zolotarev88/kicad_lib/3dmod/User Library-PCI Express Mini Card (Full-Mini Card).step

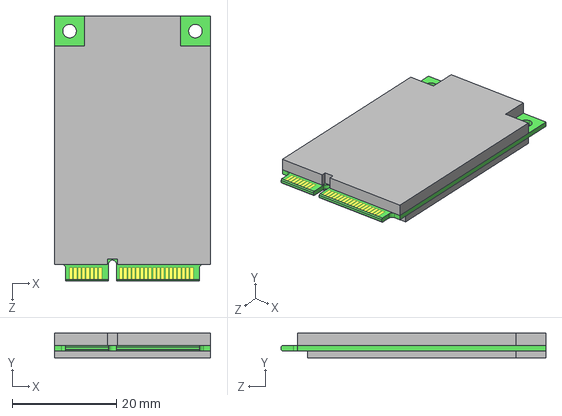
[picture p1: CAD file, 2020-07-09]
3dmod/User Library-PCI Express Mini Card (Full-Mini Card).step
30.0 x 4.75 x 51.0 mm
