zolotarev88/kicad_lib/3dmod/DG28C-B-08P-13-00A(H).stp

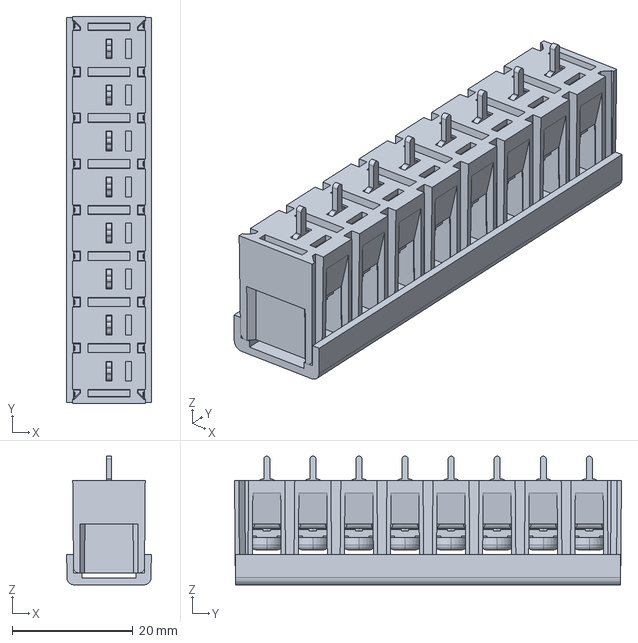
[picture p2: CAD file, 2025-03-10]
3dmod/DG28C-B-08P-13-00A(H).stp
14.0 x 64.0 x 21.3 mm
