zolotarev88/kicad_lib/3dmod/G5Q-14-EU DC5--3DModel-STEP-1.STEP

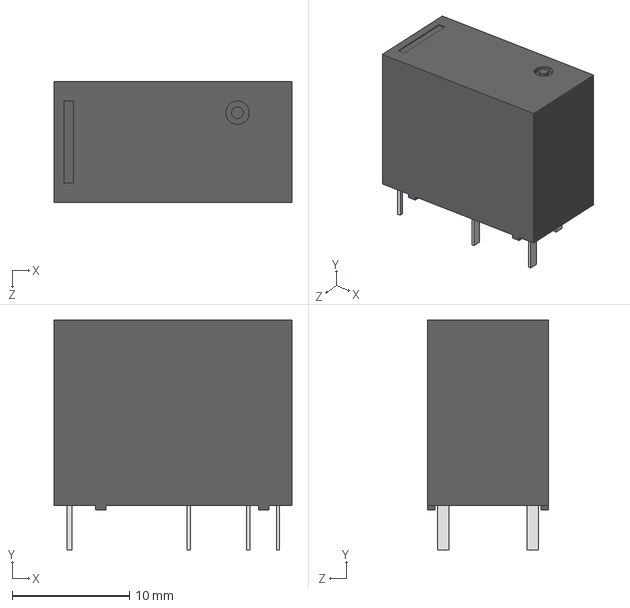
[picture p3: CAD file, 2025-03-10]
3dmod/G5Q-14-EU DC5--3DModel-STEP-1.STEP
20.3 x 19.6 x 10.3 mm
