zolotarev88/kicad_lib/3dmod/DG142V-5.08-08P-1Y-1000A(H).stp

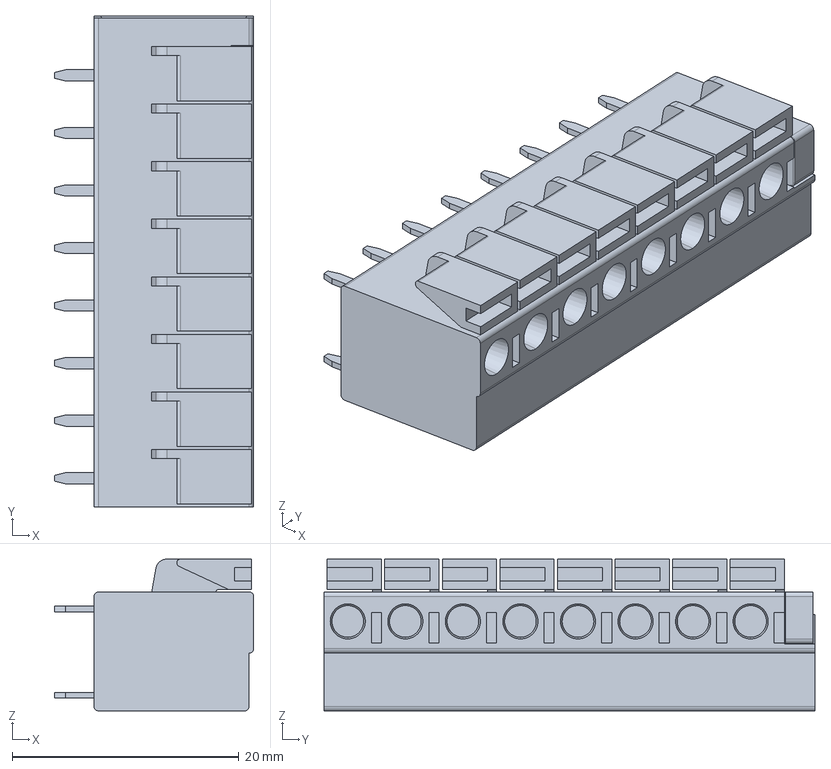
[picture p4: CAD file, 2025-03-10]
3dmod/DG142V-5.08-08P-1Y-1000A(H).stp
17.6 x 43.3 x 13.4 mm
