zolotarev88/kicad_lib/3dmod/FD6288Q.step

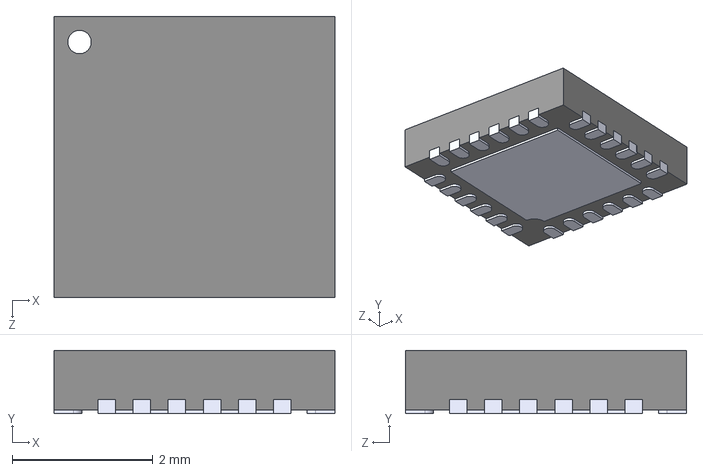
[picture p5: CAD file, 2025-03-10]
3dmod/FD6288Q.step
4.00 x 0.9 x 4.00 mm
