zolotarev88/kicad_lib/3dmod/LD05-23BxxR2.stp

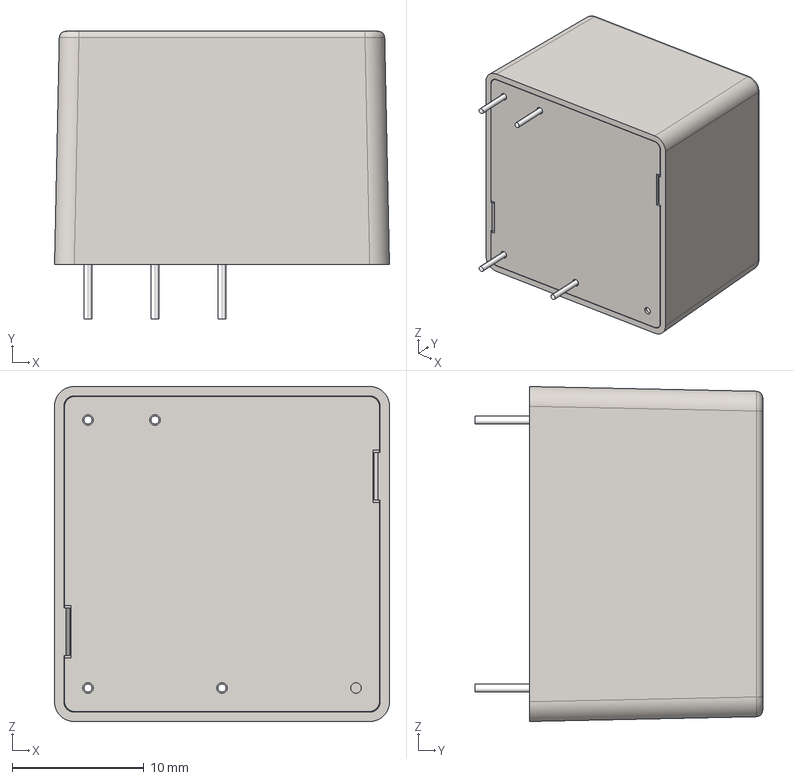
[picture p6: CAD file, 2025-03-10]
3dmod/LD05-23BxxR2.stp
25.4 x 21.8 x 25.4 mm
TOP_HOUSING_102_1
BOTTOM_HOUSING_62_1
16010014_AF2_13_1
16010014_AF5_13_1
16010014_AF3_13_1
16010014_AF4_13_1
