zolotarev88/kicad_lib/3dmod/WRA_S-3WR2.stp

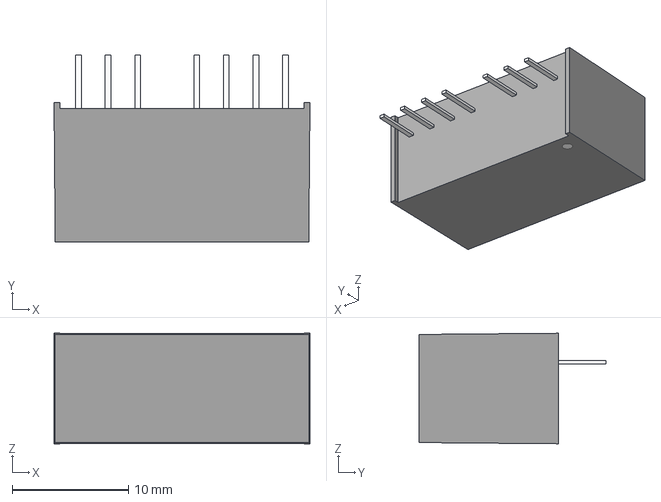
[picture p7: CAD file, 2023-01-25]
3dmod/WRA_S-3WR2.stp
22.0 x 16.1 x 9.50 mm
PIN_3_1_1_1 x 7
