zolotarev88/kicad_lib/3dmod/1-1393788-6.stp

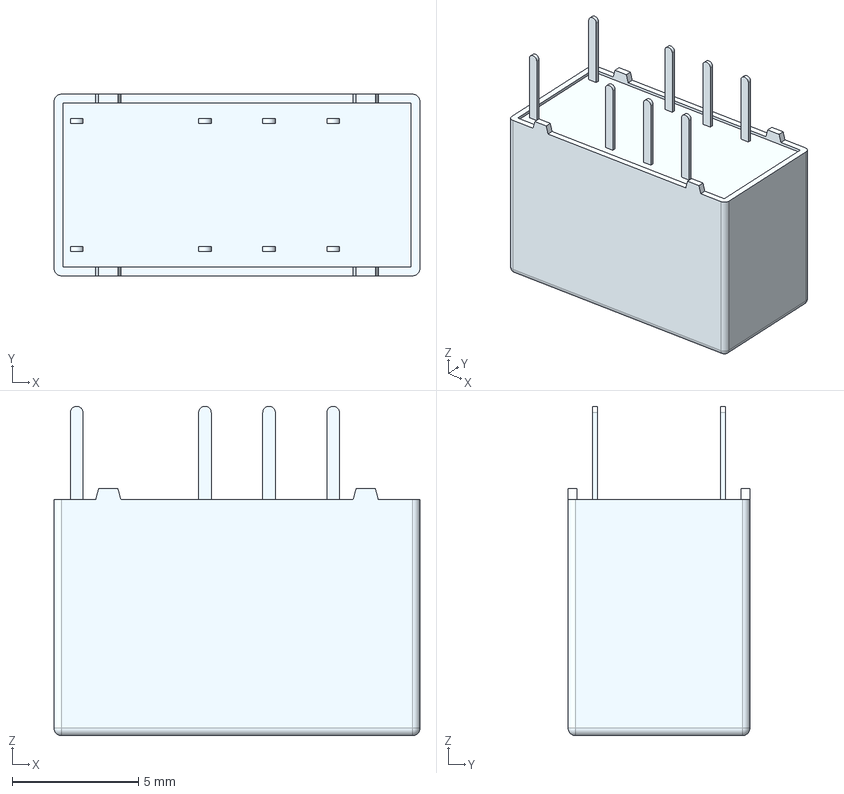
[picture p8: CAD file, 2023-01-25]
3dmod/1-1393788-6.stp
14.5 x 7.20 x 13.1 mm
