zolotarev88/kicad_lib/3dmod/ESP32-WROOM-32--3DModel-STEP-1.STEP

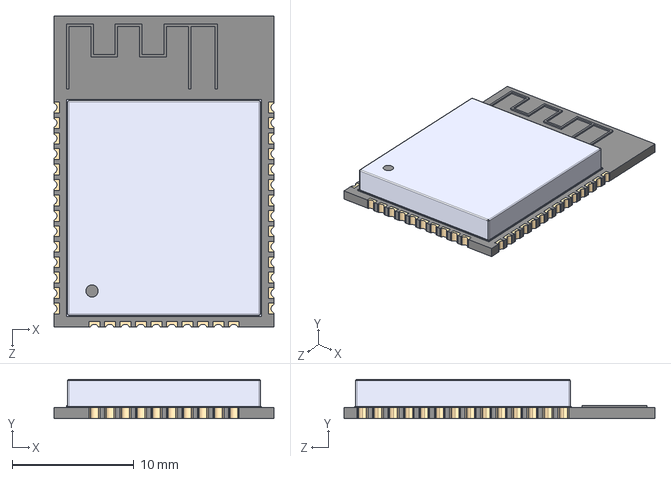
[picture p9: CAD file, 2023-01-25]
3dmod/ESP32-WROOM-32--3DModel-STEP-1.STEP
18.0 x 3.20 x 25.5 mm
