zolotarev88/kicad_lib/3dmod/User Library-CR2477.STEP

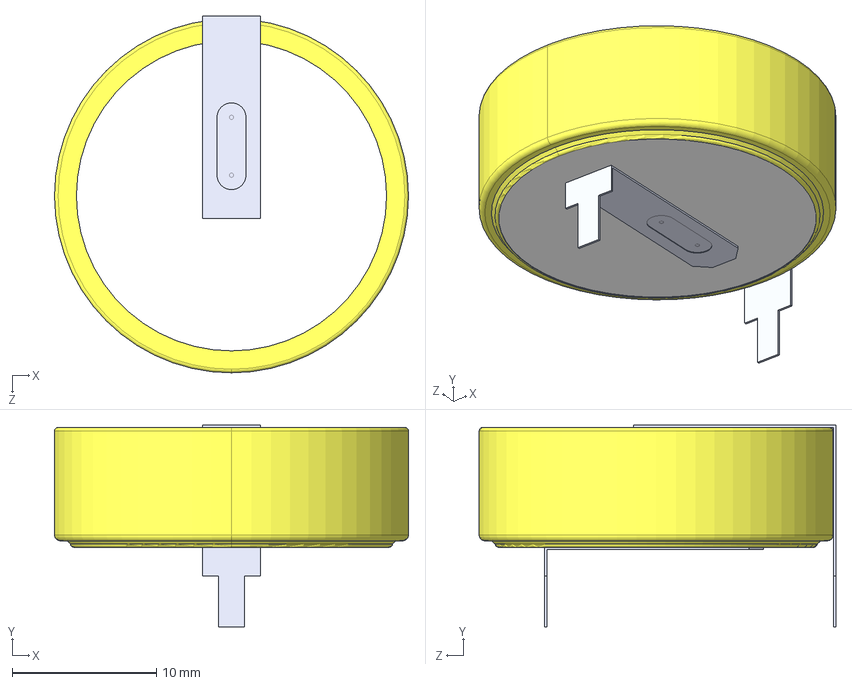
[picture p10: CAD file, 2023-01-25]
3dmod/User Library-CR2477.STEP
24.5 x 14.0 x 24.7 mm
CR2477_Body
CR2477_Anode
CR2477_Catode
