zolotarev88/kicad_lib/3dmod/User Library-096OLED.step

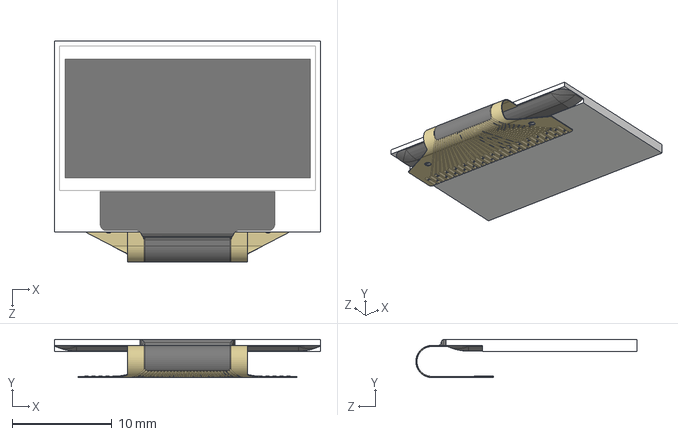
[picture p11: CAD file, 2023-01-25]
3dmod/User Library-096OLED.step
26.7 x 3.84 x 22.2 mm
