zolotarev88/kicad_lib/3dmod/RJ45-8L-B--3DModel-STEP-56544.STEP

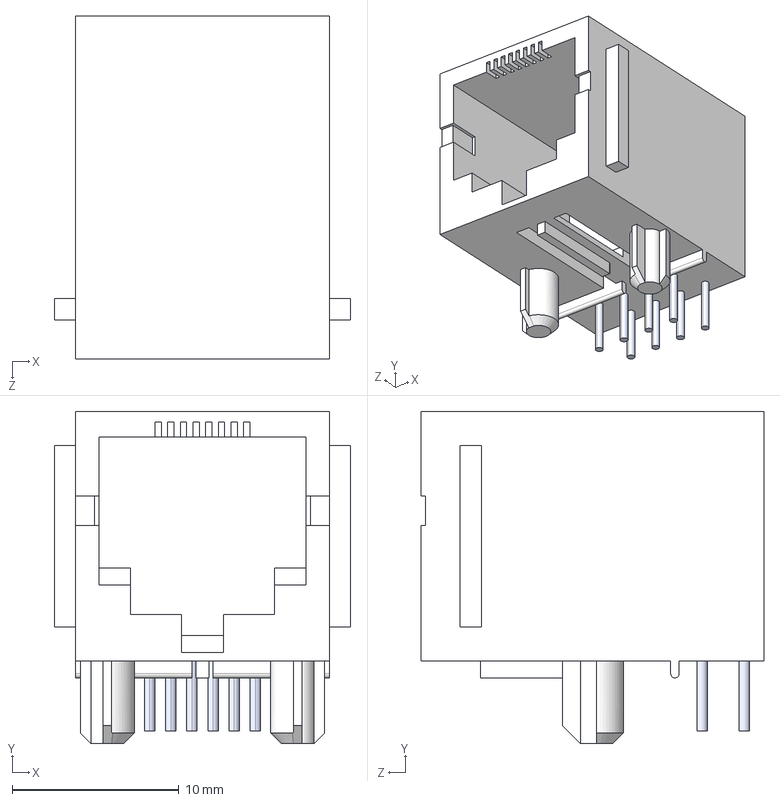
[picture p12: CAD file, 2023-01-25]
3dmod/RJ45-8L-B--3DModel-STEP-56544.STEP
17.8 x 19.9 x 20.6 mm
