zolotarev88/kicad_lib/3dmod/User Library-sd card.step

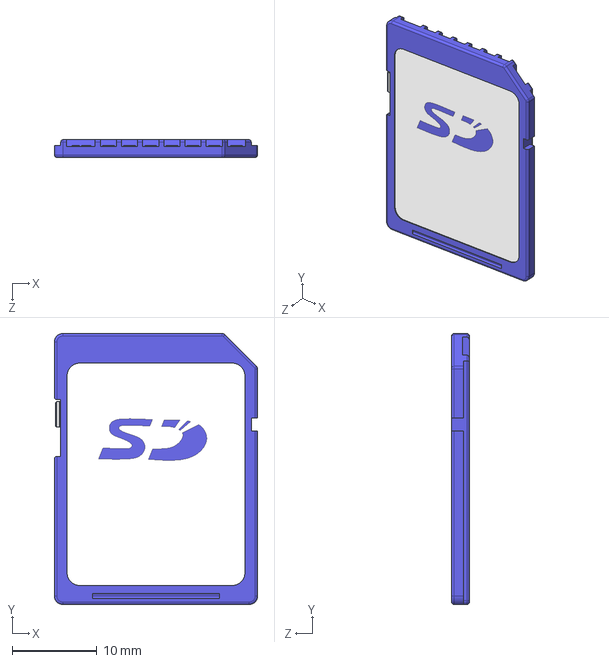
[picture p13: CAD file, 2022-01-13]
3dmod/User Library-sd card.step
24.0 x 32.0 x 2.10 mm
