zolotarev88/kicad_lib/3dmod/ACM2520-301-2P.stp

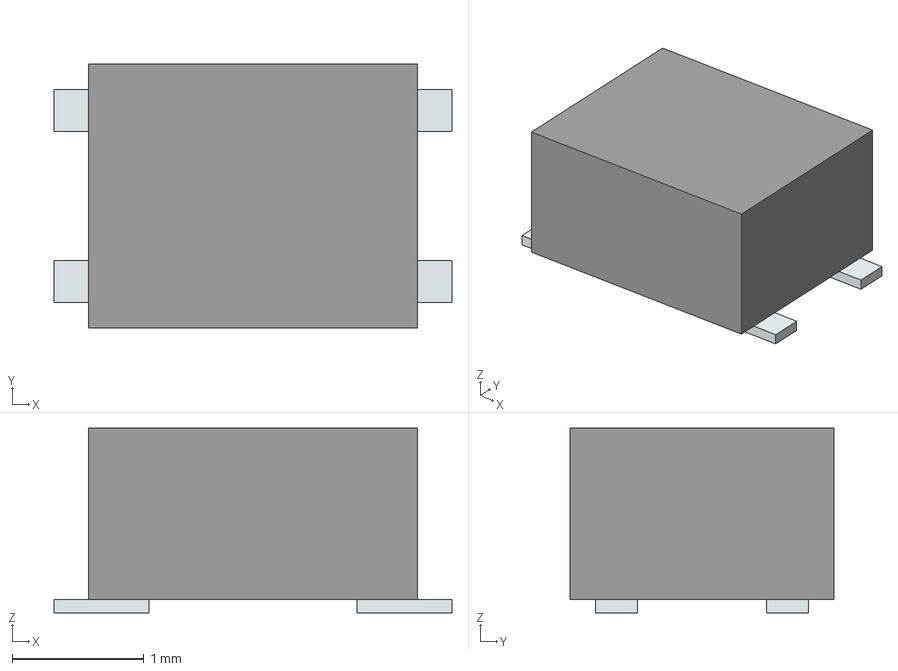
[picture p14: CAD file, 2022-01-13]
3dmod/ACM2520-301-2P.stp
3.02 x 2.00 x 1.40 mm
Pins
