zolotarev88/kicad_lib/3dmod/ACM2012-361-2P-T002.stp

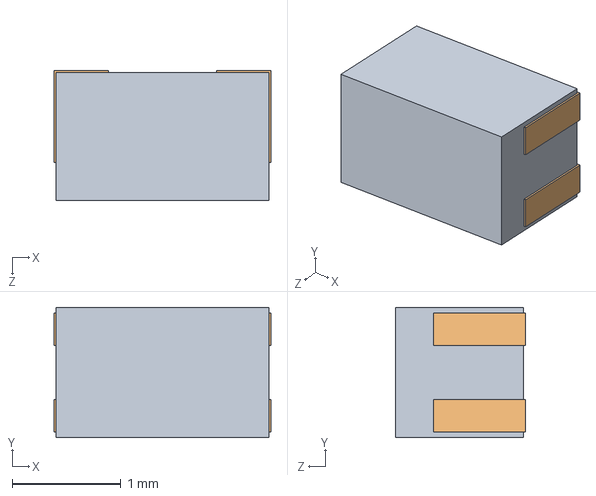
[picture p15: CAD file, 2022-01-13]
3dmod/ACM2012-361-2P-T002.stp
2.00 x 1.20 x 1.20 mm
ACM2012-T002 DRコアブロック(typ size)
ACM2012-T002 電極ブロック(typ size) x 4
