zolotarev88/kicad_lib/3dmod/LAN8720AI-CP.stp

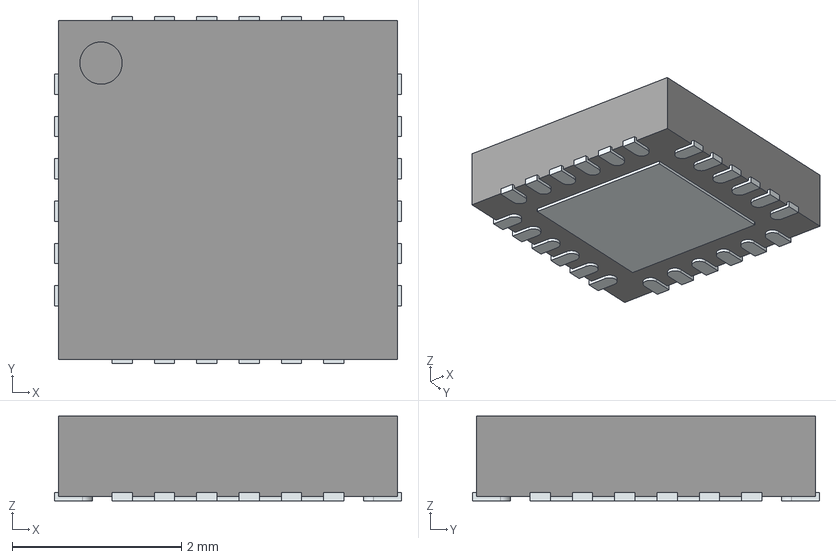
[picture p16: CAD file, 2022-01-13]
3dmod/LAN8720AI-CP.stp
4.10 x 4.10 x 1.00 mm
ThermalPin
PinsArrayLR
PinsArrayTB
