zolotarev88/kicad_lib/3dmod/mup-m015.step

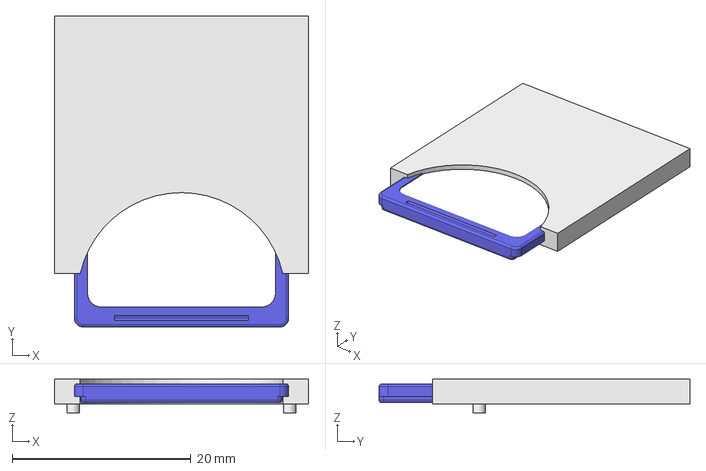
[picture p17: CAD file, 2022-01-13]
3dmod/mup-m015.step
28.4 x 34.8 x 3.80 mm
