zolotarev88/kicad_lib/3dmod/ESP32-D0WDQ6-V3.stp

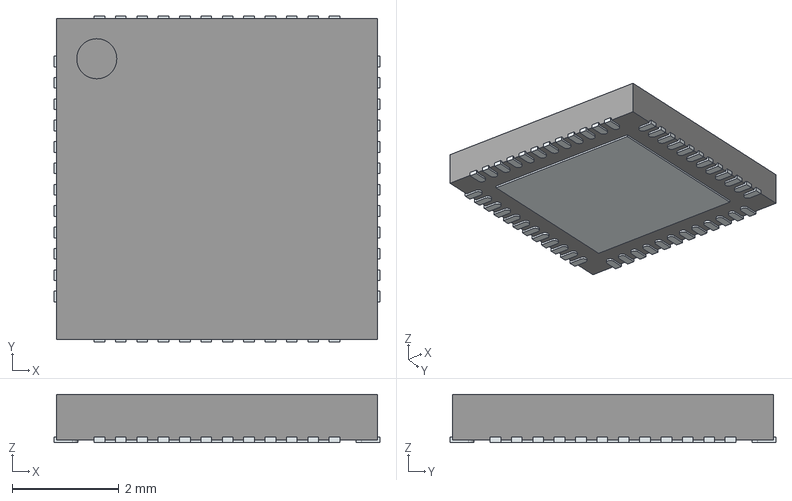
[picture p18: CAD file, 2022-01-13]
3dmod/ESP32-D0WDQ6-V3.stp
6.10 x 6.10 x 0.9 mm
ThermalPin
PinsArrayLR
PinsArrayTB
