zolotarev88/kicad_lib/3dmod/ESP32-WROOM-32D.stp

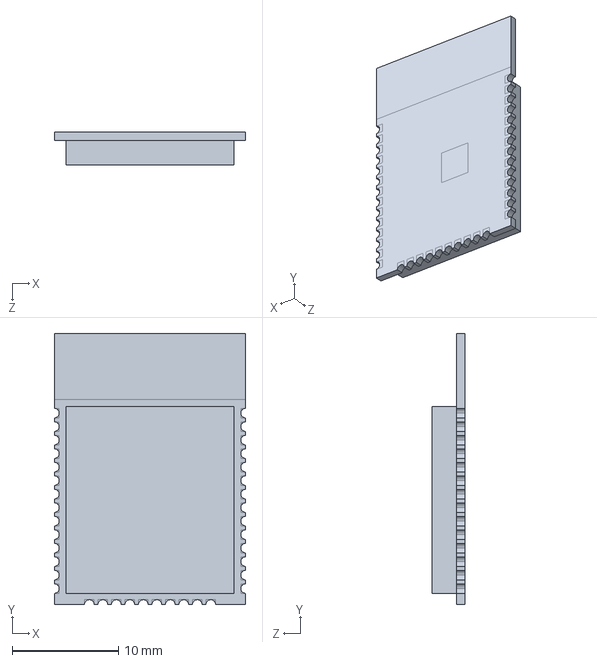
[picture p19: CAD file, 2022-01-13]
3dmod/ESP32-WROOM-32D.stp
18.0 x 25.5 x 3.10 mm
