zolotarev88/kicad_lib/3dmod/B2B-PH-SM4-TB(LF)(SN)--3DModel-STEP-56544.STEP

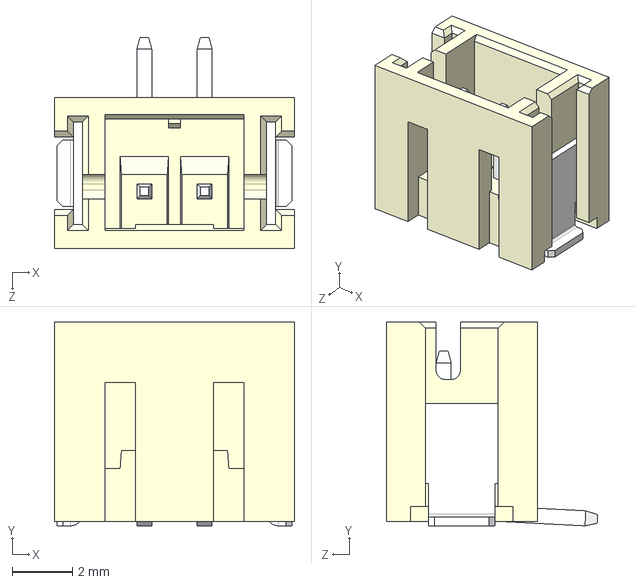
[picture p20: CAD file, 2022-01-13]
3dmod/B2B-PH-SM4-TB(LF)(SN)--3DModel-STEP-56544.STEP
7.95 x 6.75 x 7.00 mm
