zolotarev88/kicad_lib/3dmod/CR2032_MFR_FH2.stp

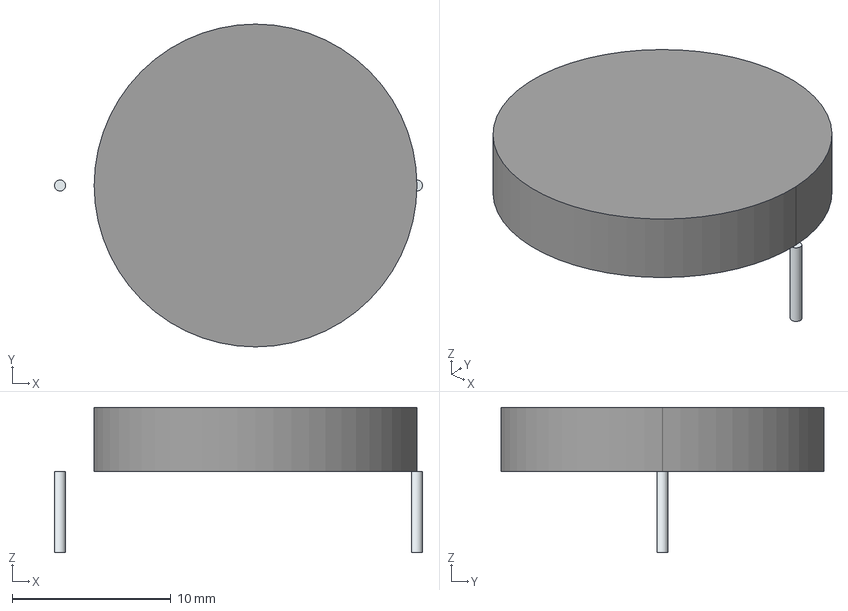
[picture p21: CAD file, 2021-04-29]
3dmod/CR2032_MFR_FH2.stp
23.2 x 20.4 x 9.15 mm
Leads x 2
