zolotarev88/kicad_lib/3dmod/TD_H_541S485H.stp

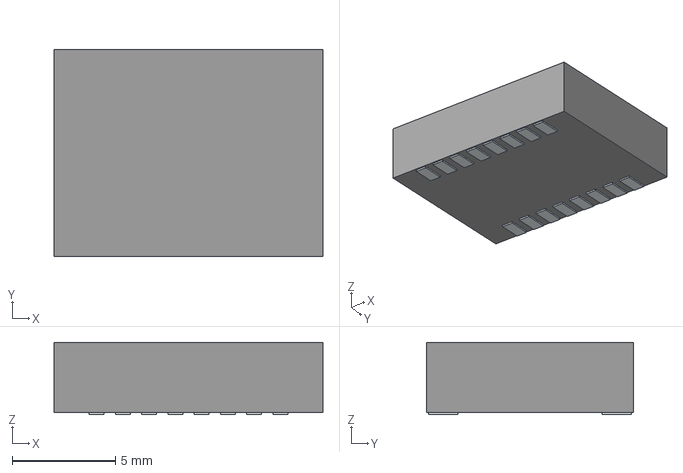
[picture p22: CAD file, 2021-04-29]
3dmod/TD_H_541S485H.stp
13.0 x 10.0 x 3.50 mm
Pins
