zolotarev88/kicad_lib/3dmod/SI3402-B-GMR.stp

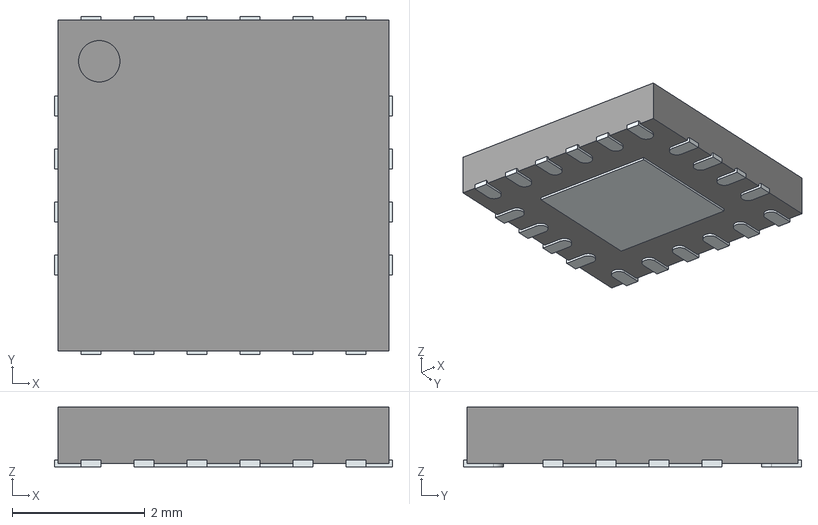
[picture p23: CAD file, 2021-04-29]
3dmod/SI3402-B-GMR.stp
5.10 x 5.10 x 0.9 mm
ThermalPin
PinsArrayLR
PinsArrayTB
