zolotarev88/kicad_lib/3dmod/QFN24_3X3X1_IVS.step

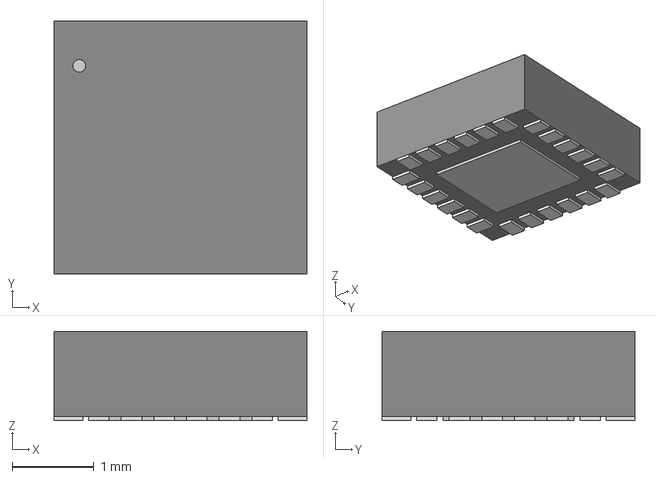
[picture p24: CAD file, 2021-04-29]
3dmod/QFN24_3X3X1_IVS.step
3.10 x 3.10 x 1.09 mm
