zolotarev88/kicad_lib/3dmod/BS-7.STEP

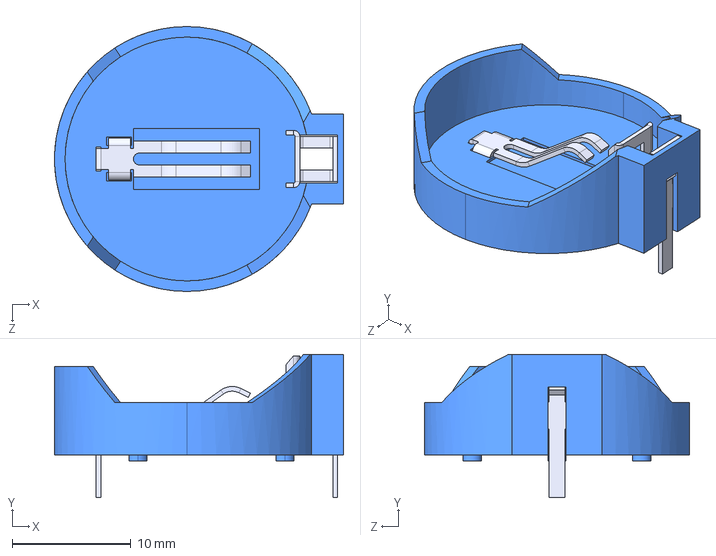
[picture p25: CAD file, 2021-04-29]
3dmod/BS-7.STEP
24.4 x 12.1 x 22.4 mm
