zolotarev88/kicad_lib/3dmod/WM8962BECSN_R.stp

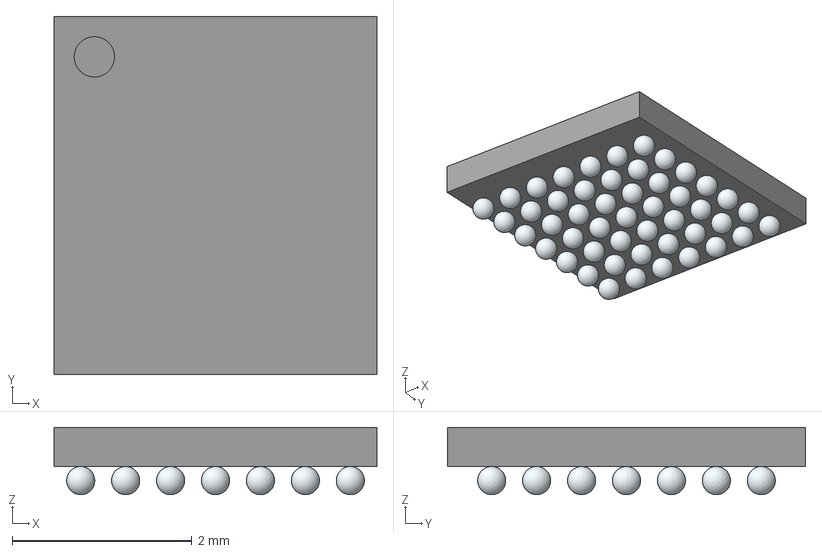
[picture p26: CAD file, 2021-03-23]
3dmod/WM8962BECSN_R.stp
3.59 x 3.98 x 0.75 mm
