zolotarev88/kicad_lib/3dmod/WM8904CGEFL_V.stp

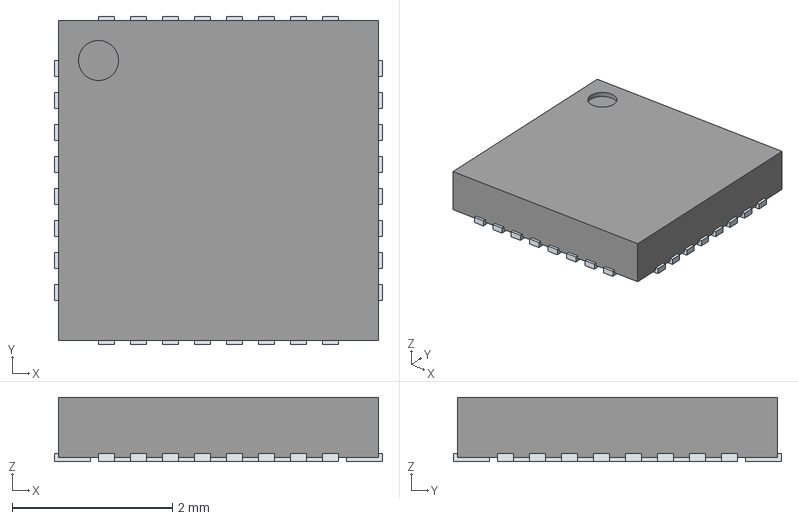
[picture p27: CAD file, 2021-03-23]
3dmod/WM8904CGEFL_V.stp
4.10 x 4.10 x 0.8 mm
ThermalPin
PinsArrayLR
PinsArrayTB
