zolotarev88/kicad_lib/3dmod/WM8960CGEFL_V.stp

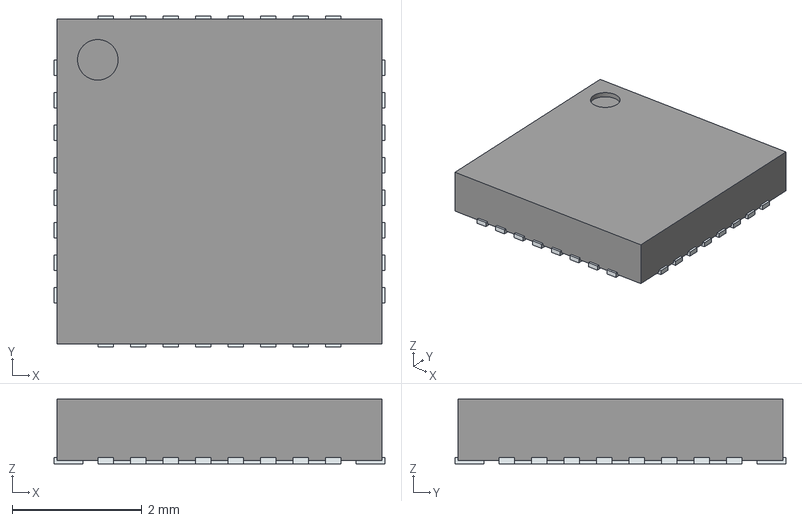
[picture p28: CAD file, 2021-03-23]
3dmod/WM8960CGEFL_V.stp
5.10 x 5.10 x 1.00 mm
ThermalPin
PinsArrayLR
PinsArrayTB
