zolotarev88/kicad_lib/3dmod/TDA7491HV13TR.stp

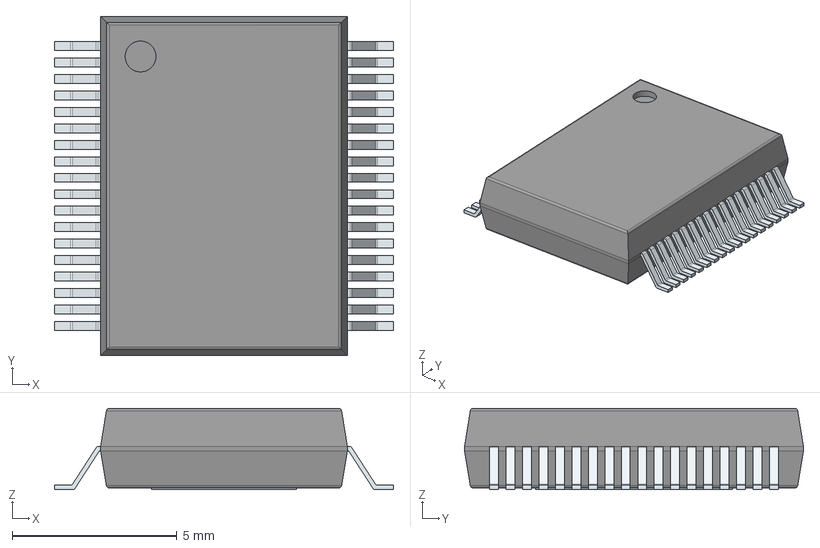
[picture p29: CAD file, 2021-01-18]
3dmod/TDA7491HV13TR.stp
10.3 x 10.3 x 2.47 mm
PinsArrayLR
ThermalPad
