zolotarev88/kicad_lib/3dmod/TPA3138D2PWPR.stp

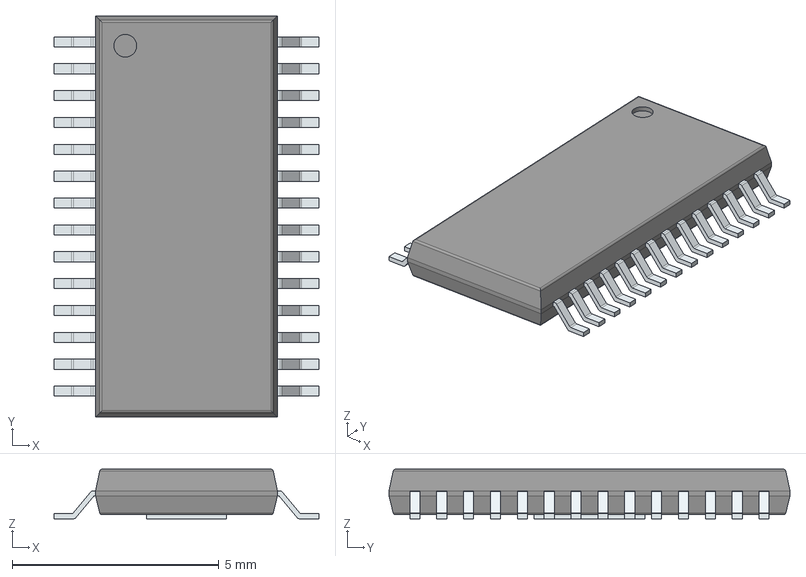
[picture p30: CAD file, 2021-01-18]
3dmod/TPA3138D2PWPR.stp
6.40 x 9.70 x 1.20 mm
PinsArrayLR
ThermalPad
