zolotarev88/kicad_lib/3dmod/B3B-PH-SM4-TB.STEP

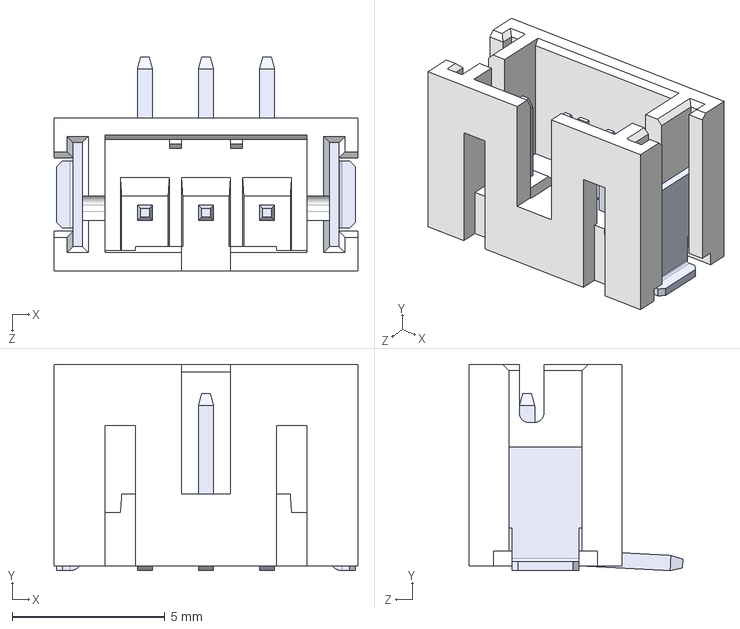
[picture p31: CAD file, 2020-12-24]
3dmod/B3B-PH-SM4-TB.STEP
9.95 x 6.75 x 7.00 mm
