zolotarev88/kicad_lib/3dmod/IS62WV102416FBLL-45BLI.stp

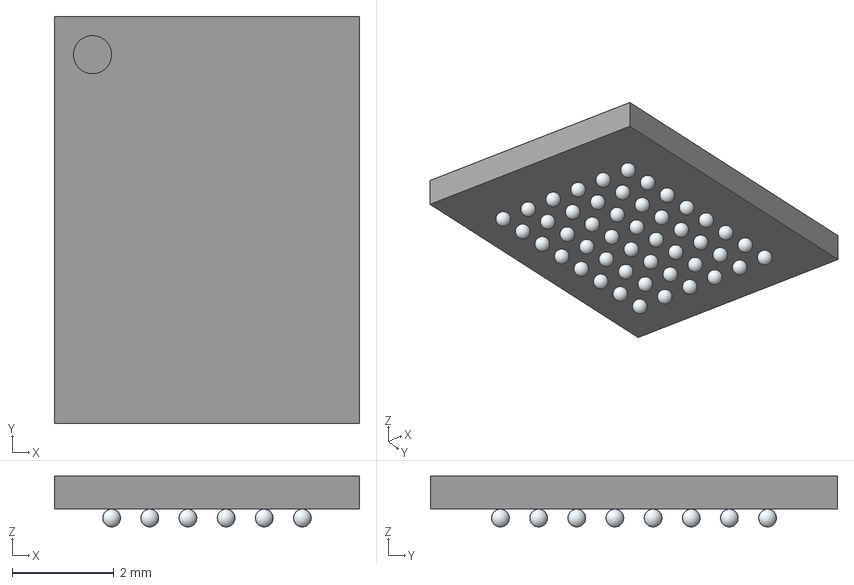
[picture p32: CAD file, 2020-12-24]
3dmod/IS62WV102416FBLL-45BLI.stp
6.00 x 8.00 x 1.00 mm
