zolotarev88/kicad_lib/3dmod/TP4056.stp

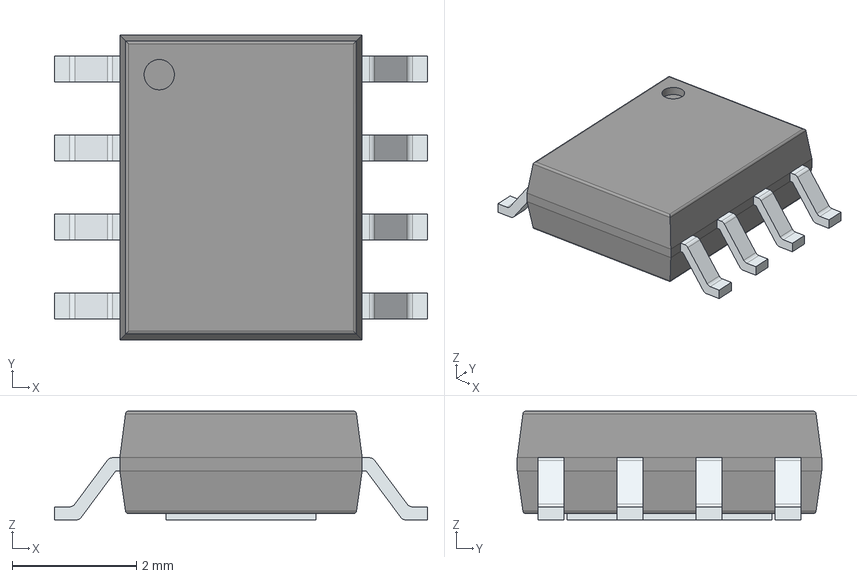
[picture p33: CAD file, 2020-12-24]
3dmod/TP4056.stp
6.00 x 4.90 x 1.75 mm
PinsArrayLR
ThermalPad
