zolotarev88/kicad_lib/3dmod/S4B-PH-K-S.STEP

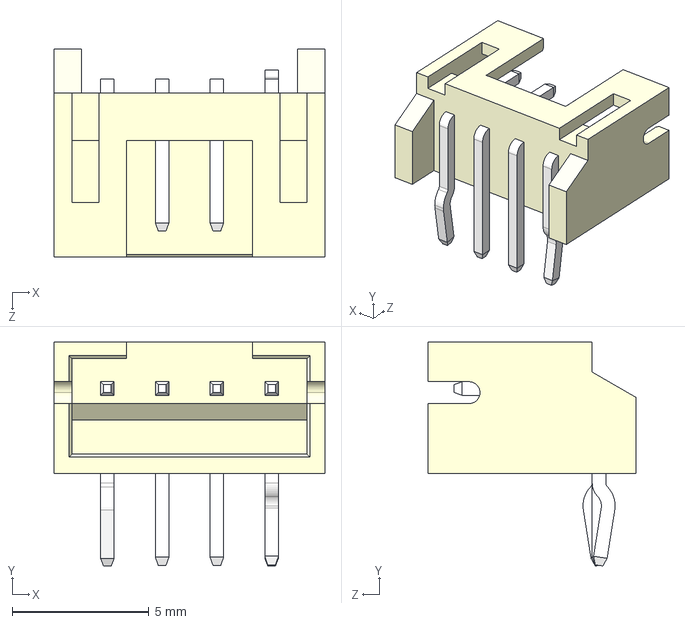
[picture p34: CAD file, 2020-12-24]
3dmod/S4B-PH-K-S.STEP
9.90 x 8.18 x 7.60 mm
