zolotarev88/kicad_lib/3dmod/c-2041021-1-b-3d.stp

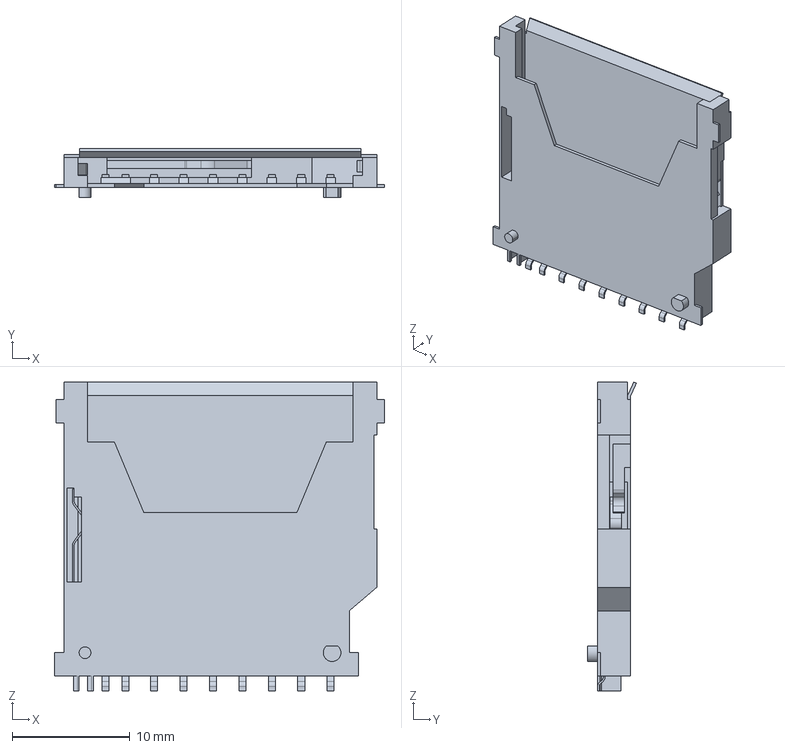
[picture p35: CAD file, 2020-12-24]
3dmod/c-2041021-1-b-3d.stp
28.0 x 4.15 x 26.2 mm
