zolotarev88/kicad_lib/3dmod/RCLAMP0524PATCT.stp

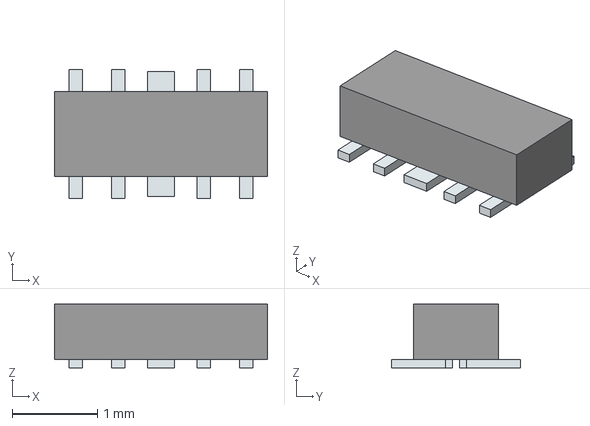
[picture p36: CAD file, 2020-12-24]
3dmod/RCLAMP0524PATCT.stp
2.50 x 1.51 x 0.75 mm
Pins
