zolotarev88/kicad_lib/3dmod/SM03B-SRSS-TB(LF)(SN)--3DModel-STEP-56544.STEP

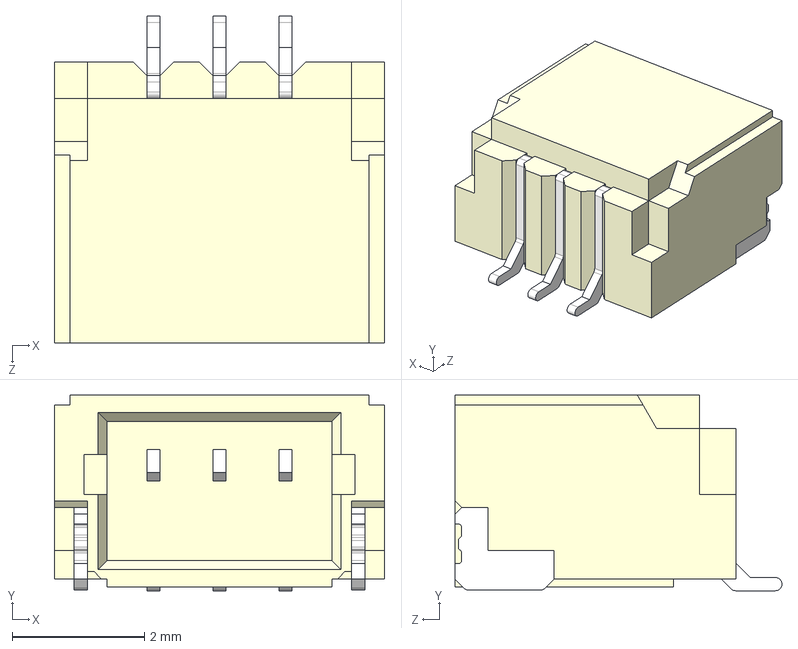
[picture p37: CAD file, 2020-12-24]
3dmod/SM03B-SRSS-TB(LF)(SN)--3DModel-STEP-56544.STEP
5.00 x 2.96 x 4.95 mm
