zolotarev88/kicad_lib/3dmod/GL823K.stp

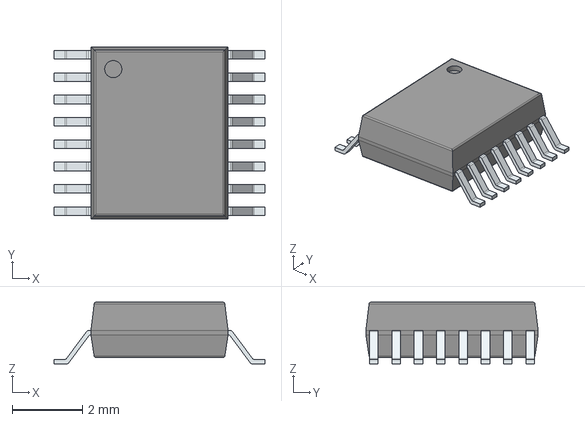
[picture p38: CAD file, 2020-12-24]
3dmod/GL823K.stp
6.00 x 4.90 x 1.75 mm
PinsArrayLR
