zolotarev88/kicad_lib/3dmod/TS-1187A-B-A-B--3DModel-STEP-56544.STEP

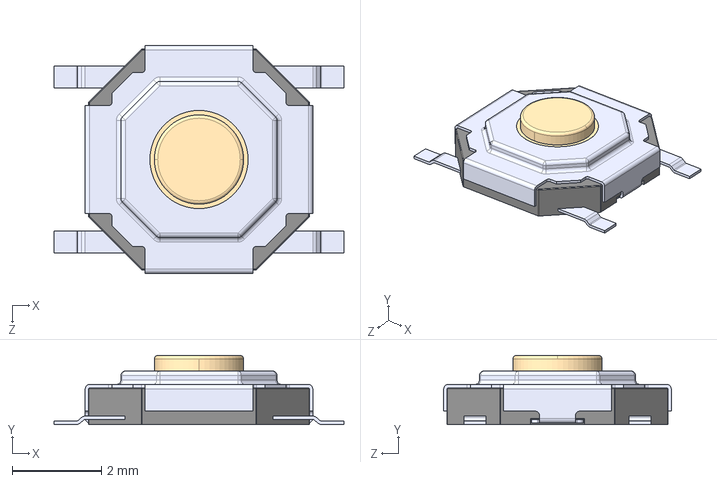
[picture p39: CAD file, 2020-09-29]
3dmod/TS-1187A-B-A-B--3DModel-STEP-56544.STEP
6.50 x 1.55 x 5.10 mm
