zolotarev88/kicad_lib/3dmod/SWPA3015S2R2NT.stp

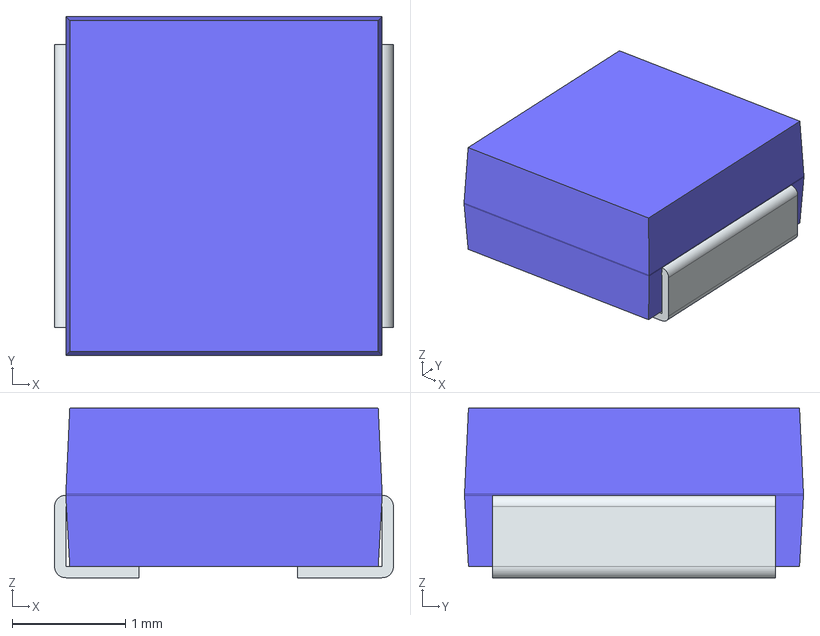
[picture p41: CAD file, 2020-09-14]
3dmod/SWPA3015S2R2NT.stp
3.00 x 3.00 x 1.50 mm
FilletPin1
FilletPin2
