zolotarev88/kicad_lib/3dmod/User Library-FFC 6x05.step

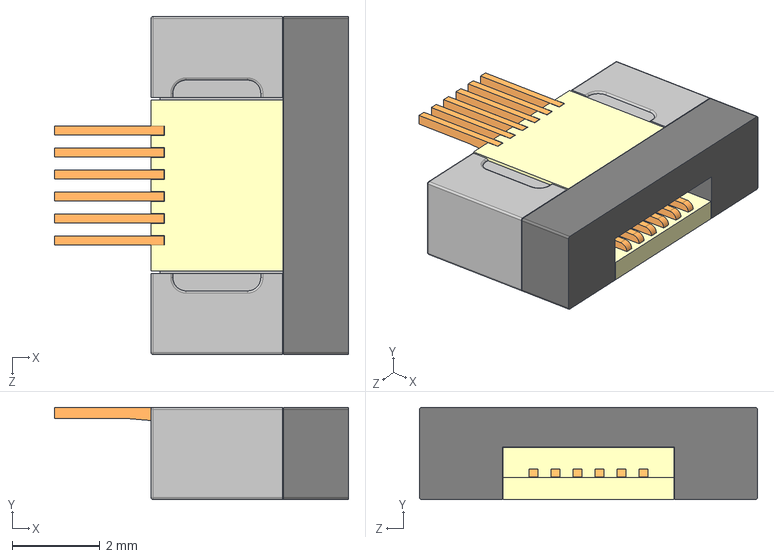
[picture p42: CAD file, 2020-09-14]
3dmod/User Library-FFC 6x05.step
6.70 x 2.10 x 7.70 mm
