zolotarev88/kicad_lib/3dmod/3-1734839-0--3DModel-STEP-56544.STEP

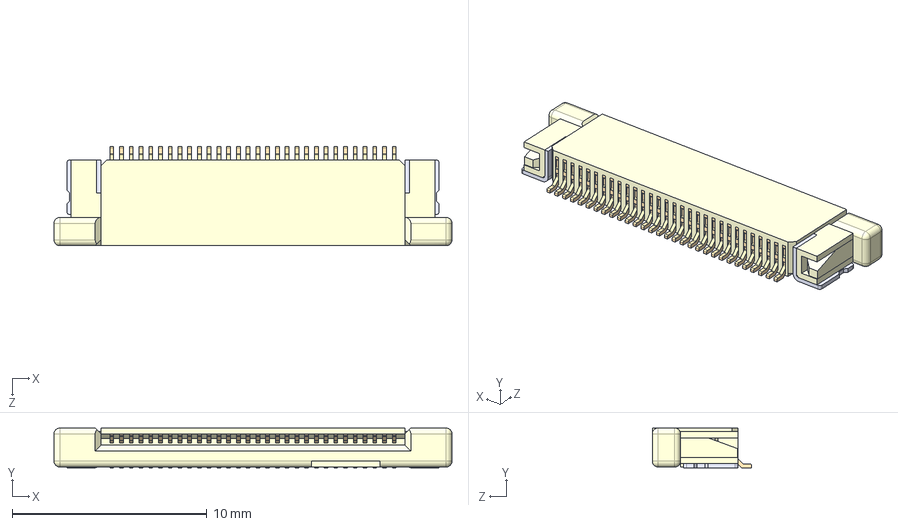
[picture p43: CAD file, 2020-09-14]
3dmod/3-1734839-0--3DModel-STEP-56544.STEP
20.4 x 2.05 x 5.10 mm
