zolotarev88/kicad_lib/3dmod/SWPA4012S2R2NT--3DModel-STEP-56544.STEP

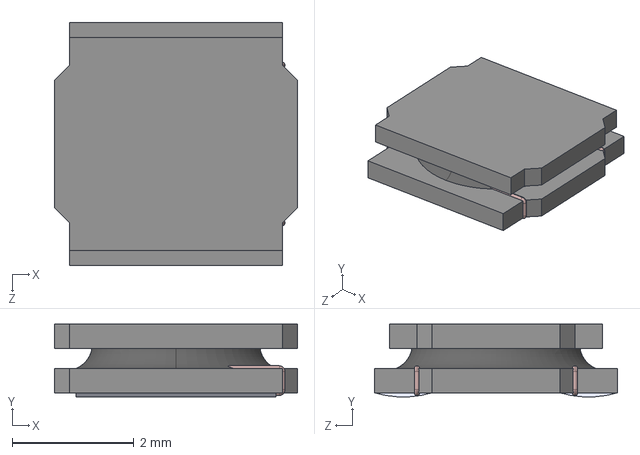
[picture p44: CAD file, 2020-09-14]
3dmod/SWPA4012S2R2NT--3DModel-STEP-56544.STEP
4.00 x 1.20 x 4.00 mm
