zolotarev88/kicad_lib/3dmod/SM04B-SRSS-TB(LF)(SN)--3DModel-STEP-56544.STEP

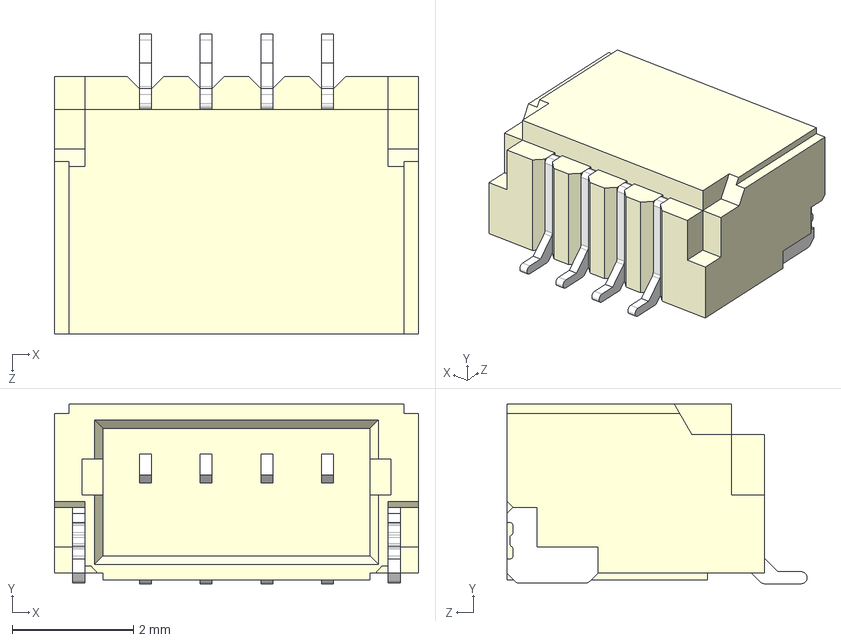
[picture p45: CAD file, 2020-09-14]
3dmod/SM04B-SRSS-TB(LF)(SN)--3DModel-STEP-56544.STEP
6.00 x 2.96 x 4.95 mm
