zolotarev88/kicad_lib/3dmod/User Library-mc-306 crystal.step

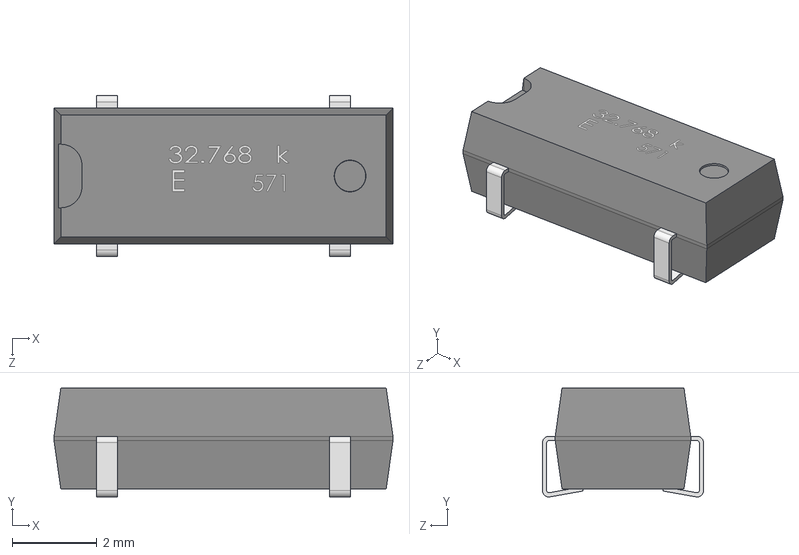
[picture p46: CAD file, 2020-09-14]
3dmod/User Library-mc-306 crystal.step
8.00 x 2.57 x 3.80 mm
