zolotarev88/kicad_lib/3dmod/6027.step

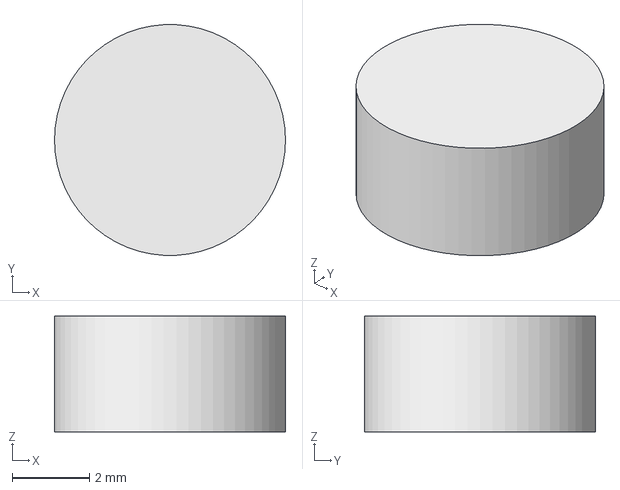
[picture p47: CAD file, 2020-09-14]
3dmod/6027.step
6.00 x 5.99 x 3.00 mm
