zolotarev88/kicad_lib/3dmod/3-1734592-5.stp

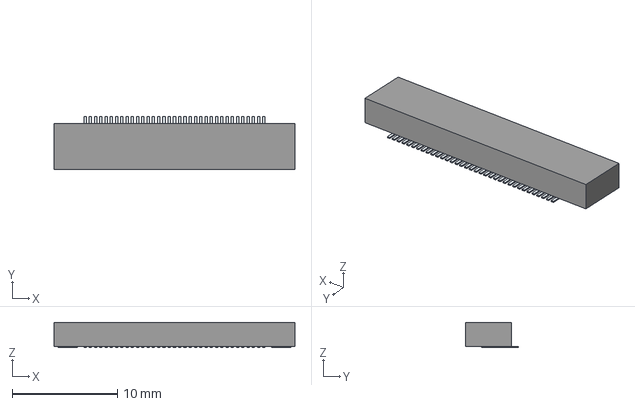
[picture p48: CAD file, 2020-09-14]
3dmod/3-1734592-5.stp
22.9 x 5.07 x 2.40 mm
Pins
