zolotarev88/kicad_lib/3dmod/NT6AN256T32AV-J2.stp

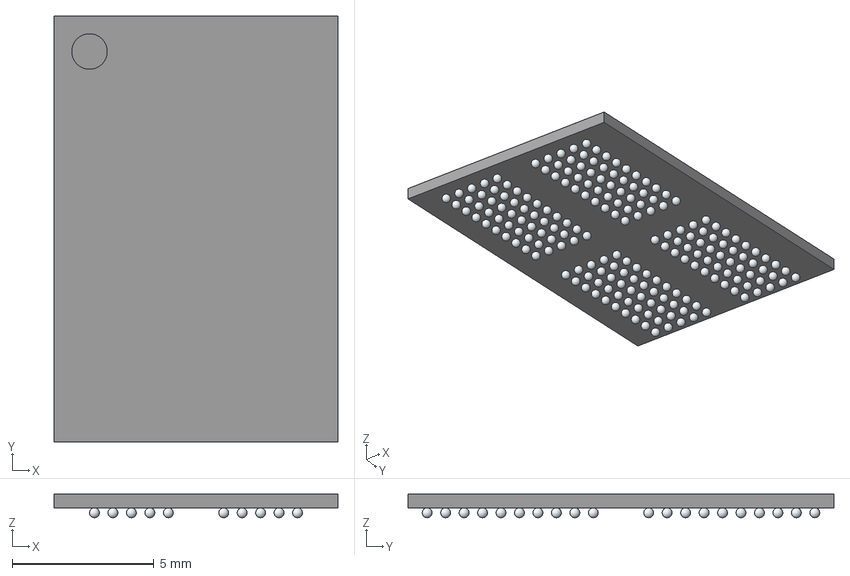
[picture p49: CAD file, 2020-08-24]
3dmod/NT6AN256T32AV-J2.stp
10.0 x 15.0 x 0.83 mm
A1
A2
A3
A4
A5
A8
A9
A10
A11
A12
B1
B2
B3
B4
B5
B8
B9
B10
B11
B12
C1
C2
C3
C4
C5
C8
C9
C10
C11
C12
D1
D2
D3
D4
D5
D8
D9
D10
D11
D12
E1
E2
E3
E4
E5
E8
E9
E10
E11
E12
F1
F2
F3
F4
F5
F8
F9
F10
F11
F12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
