zolotarev88/kicad_lib/3dmod/L-7104FO-2GD_.stp

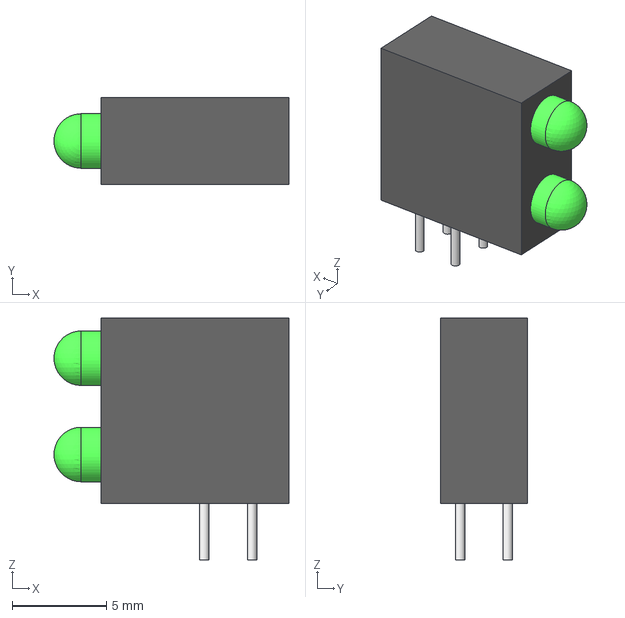
[picture p50: CAD file, 2020-08-24]
3dmod/L-7104FO-2GD_.stp
12.5 x 4.60 x 12.8 mm
