zolotarev88/kicad_lib/3dmod/ADM2682EBRIZ.stp

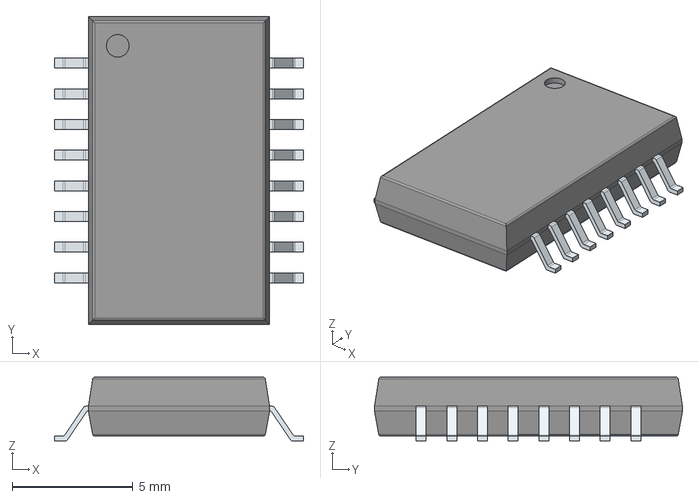
[picture p51: CAD file, 2020-08-24]
3dmod/ADM2682EBRIZ.stp
10.3 x 12.8 x 2.64 mm
PinsArrayLR
