zolotarev88/kicad_lib/3dmod/User Library-compute_module.step

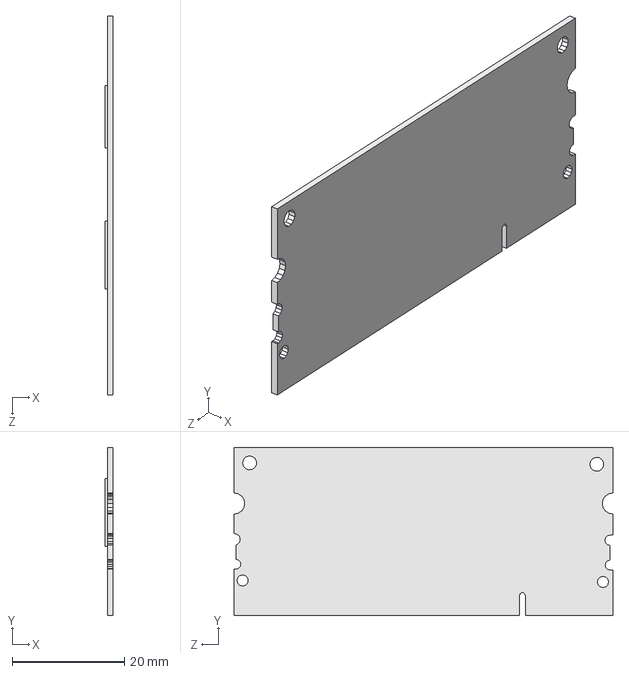
[picture p52: CAD file, 2020-08-24]
3dmod/User Library-compute_module.step
1.50 x 30.0 x 67.6 mm
