zolotarev88/kicad_lib/3dmod/SRF0905-202Y.stp

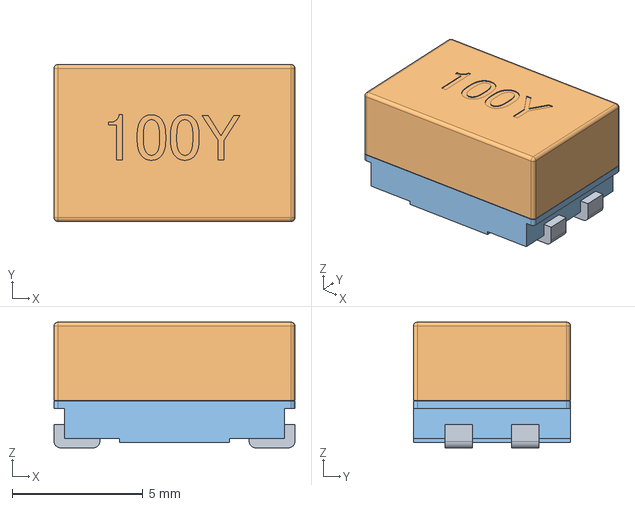
[picture p53: CAD file, 2020-08-24]
3dmod/SRF0905-202Y.stp
9.20 x 6.00 x 4.80 mm
