zolotarev88/kicad_lib/3dmod/NSS1C201LT1G.stp

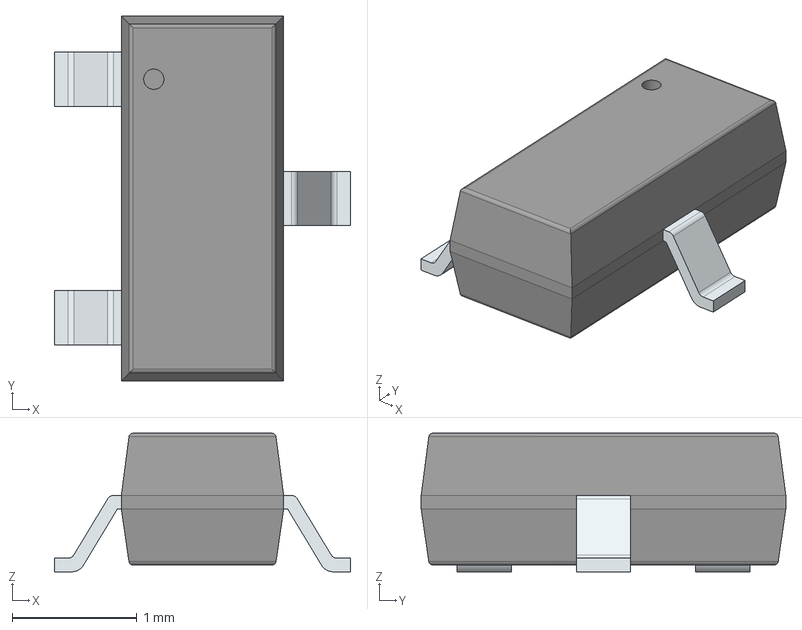
[picture p54: CAD file, 2020-08-24]
3dmod/NSS1C201LT1G.stp
2.37 x 2.92 x 1.11 mm
PinsArrayL
FilletPinR
