zolotarev88/kicad_lib/3dmod/AM1D-0505SZ.stp

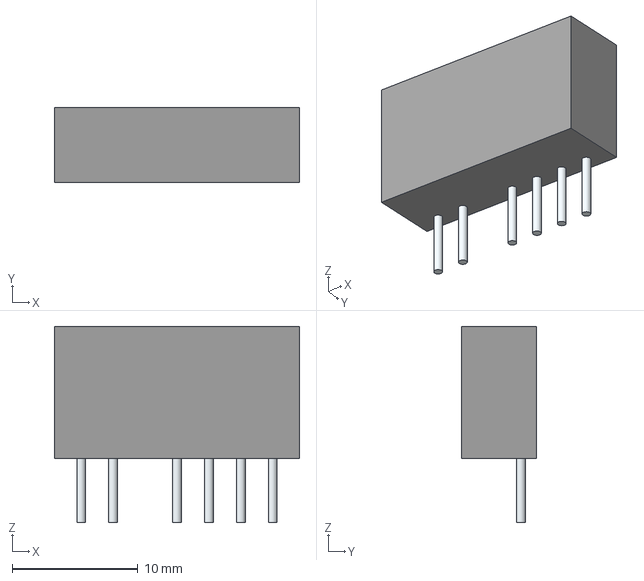
[picture p55: CAD file, 2020-08-24]
3dmod/AM1D-0505SZ.stp
19.5 x 6.00 x 15.6 mm
Leads x 6
