zolotarev88/kicad_lib/3dmod/PJ-327F-5A.STEP

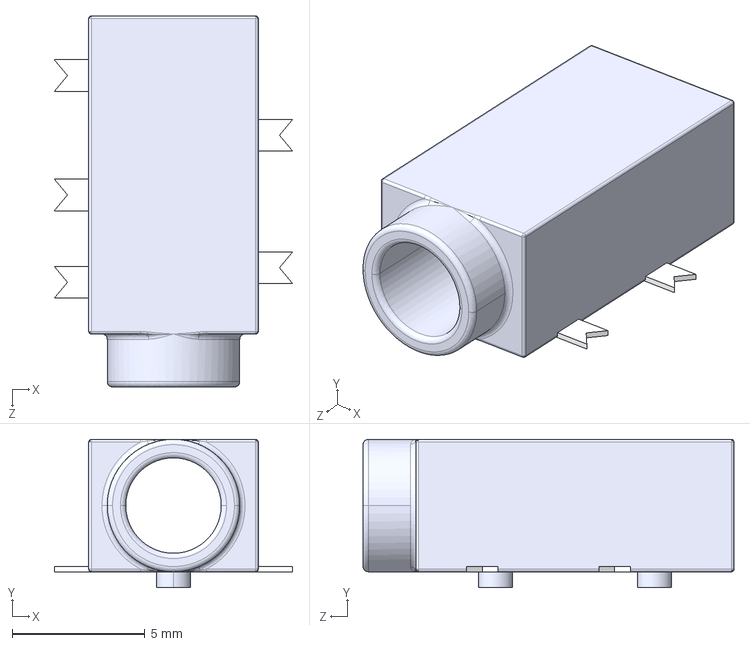
[picture p56: CAD file, 2020-08-24]
3dmod/PJ-327F-5A.STEP
9.00 x 5.60 x 14.0 mm
