zolotarev88/kicad_lib/3dmod/pxc_2203903_02_ICC25-H-4R5-0-7035_3D.stp

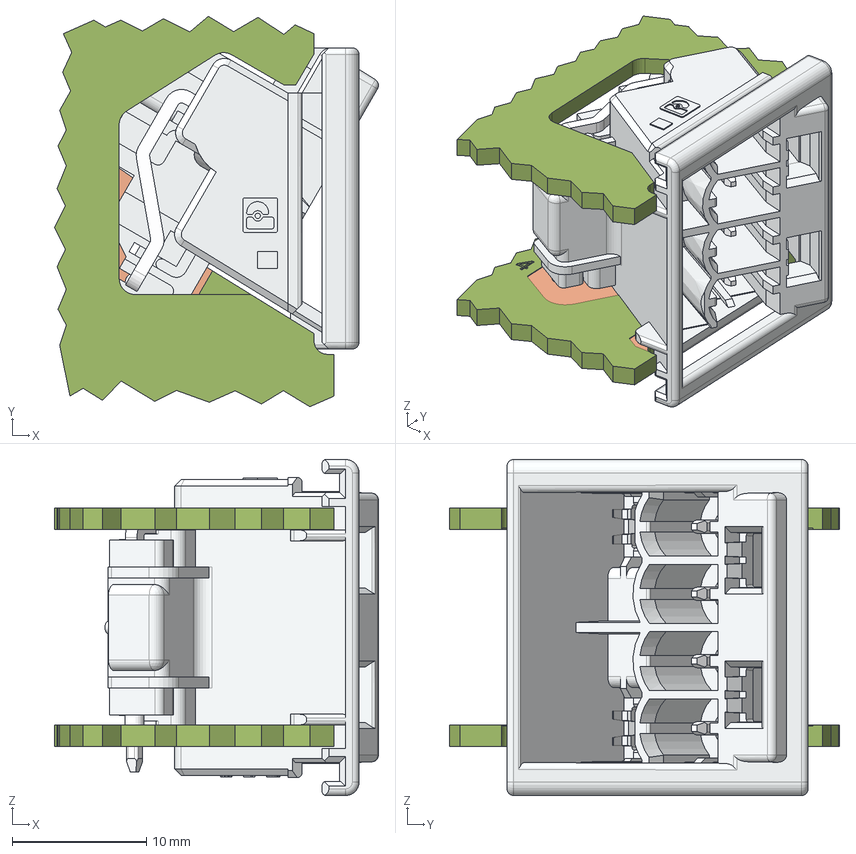
[picture p57: CAD file, 2020-08-24]
3dmod/pxc_2203903_02_ICC25-H-4R5-0-7035_3D.stp
24.1 x 29.0 x 25.0 mm
PCB_FRAGMENT_SECOND_ICC25_H4R5_0
ICC25-H-4R5.0__01083879_H.Select
PCB-FRAGMENT_MAIN_ICC25-H_4R5.0_01087108
