zolotarev88/kicad_lib/3dmod/PS2801C-1-F3-A.stp

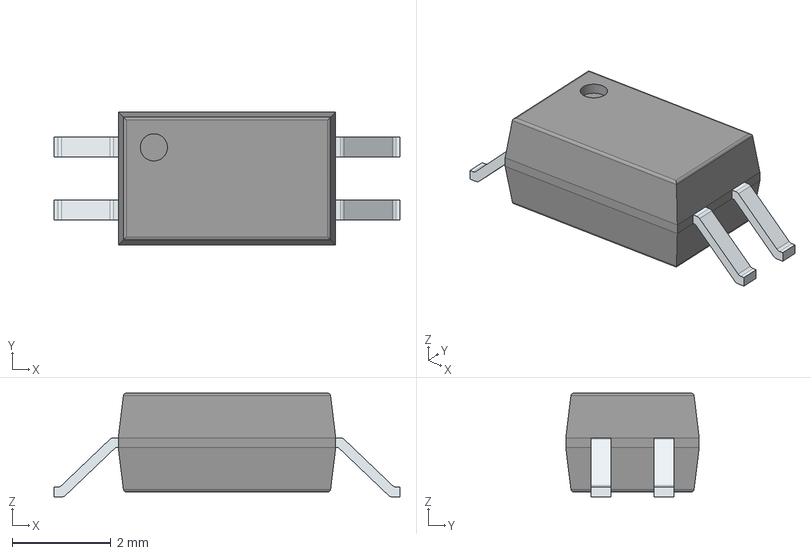
[picture p58: CAD file, 2020-08-24]
3dmod/PS2801C-1-F3-A.stp
7.00 x 2.70 x 2.10 mm
PinsArrayLR
