zolotarev88/kicad_lib/3dmod/User Library-JST_B2B-PH-SM4-TB-white.step

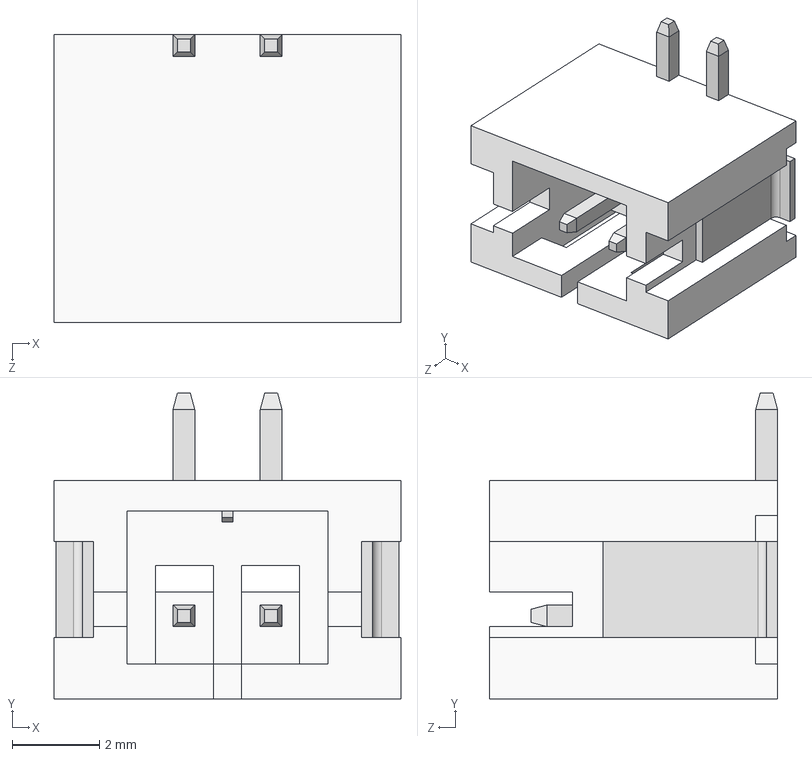
[picture p59: CAD file, 2020-07-22]
3dmod/User Library-JST_B2B-PH-SM4-TB-white.step
7.95 x 7.00 x 6.60 mm
