zolotarev88/kicad_lib/3dmod/User Library-ltst-s310f2kt.step

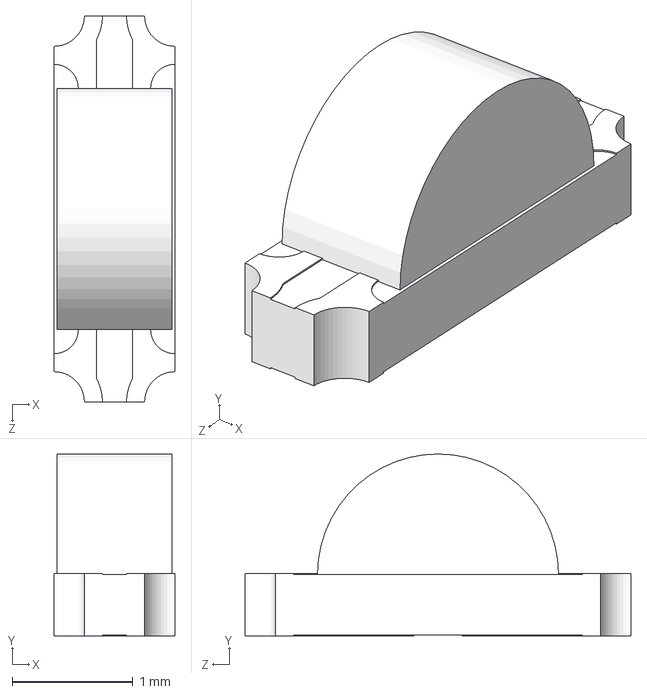
[picture p60: CAD file, 2020-07-22]
3dmod/User Library-ltst-s310f2kt.step
1.00 x 1.51 x 3.20 mm
