zolotarev88/kicad_lib/3dmod/User Library-LED_RGB _4SMD.step

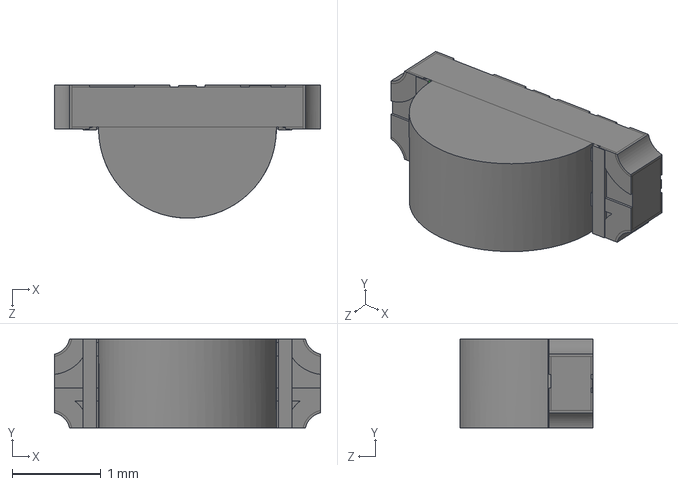
[picture p61: CAD file, 2020-07-22]
3dmod/User Library-LED_RGB _4SMD.step
3.00 x 1.00 x 1.50 mm
