zolotarev88/kicad_lib/3dmod/User Library-PTS645SL43SMTR92-LFS.STEP

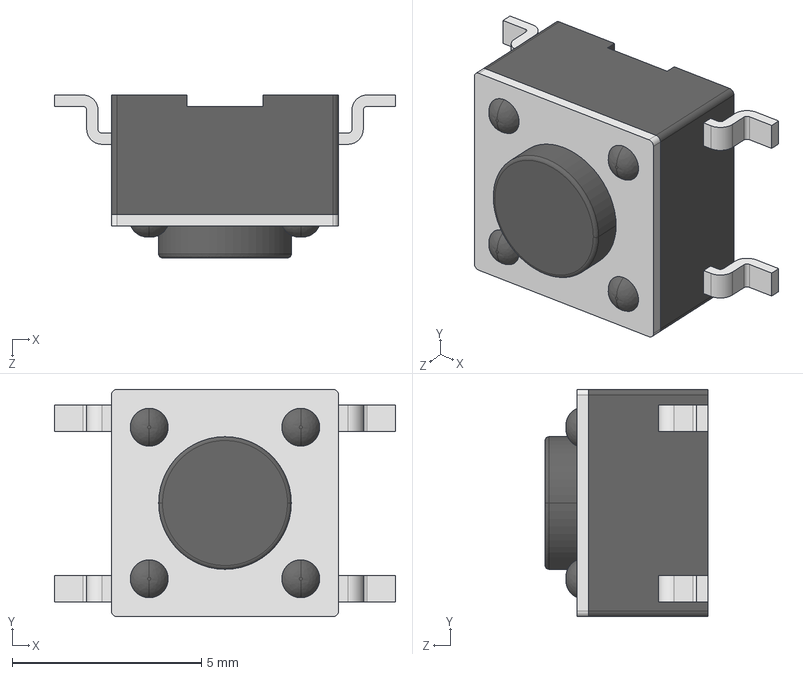
[picture p62: CAD file, 2020-07-22]
3dmod/User Library-PTS645SL43SMTR92-LFS.STEP
9.00 x 6.00 x 4.30 mm
