zolotarev88/kicad_lib/3dmod/2-2013022-1.stp

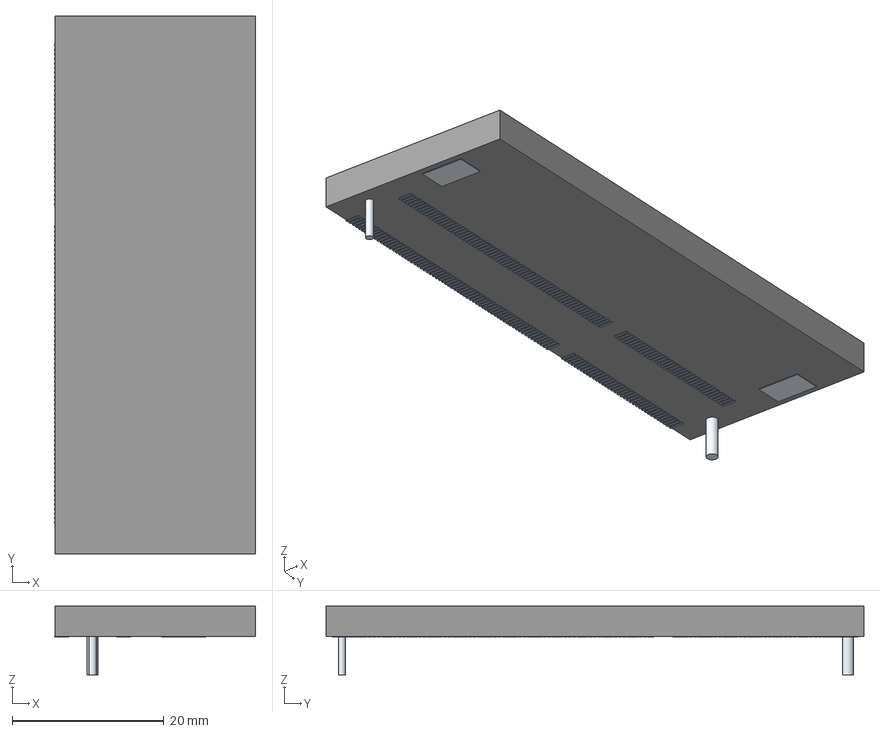
[picture p63: CAD file, 2020-07-18]
3dmod/2-2013022-1.stp
26.6 x 71.0 x 9.10 mm
Pins
Leads x 2
