zolotarev88/kicad_lib/3dmod/c-1-1747981-2-l-3d NEW.STEP

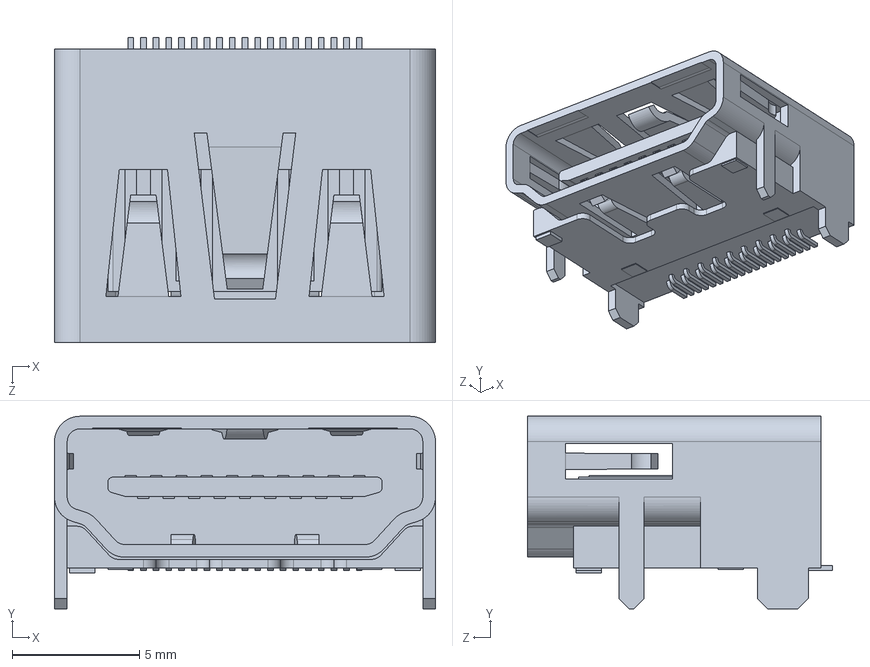
[picture p64: CAD file, 2020-07-18]
3dmod/c-1-1747981-2-l-3d NEW.STEP
15.0 x 7.58 x 12.0 mm
