zolotarev88/kicad_lib/3dmod/c-8-1747981-1-l-3d.stp

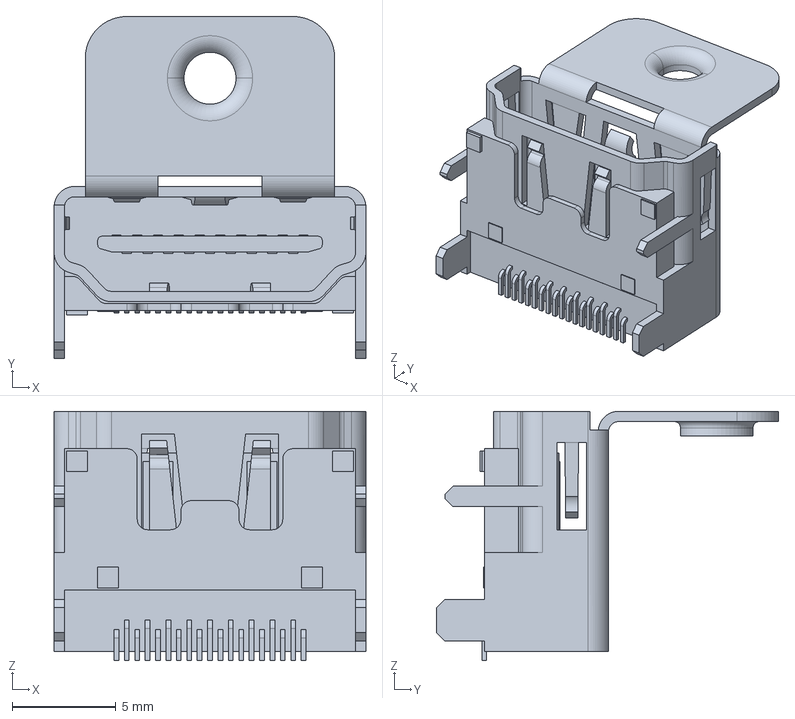
[picture p65: CAD file, 2020-07-18]
3dmod/c-8-1747981-1-l-3d.stp
15.0 x 16.4 x 12.0 mm
