zolotarev88/kicad_lib/3dmod/USB Type C Port (SMD Type).STEP

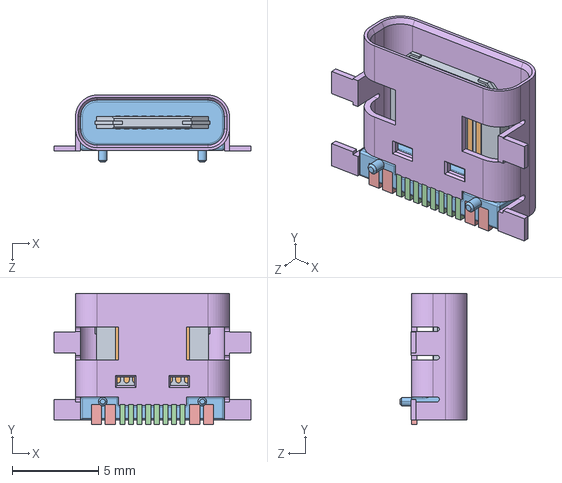
[picture p66: CAD file, 2020-07-18]
3dmod/USB Type C Port (SMD Type).STEP
11.4 x 7.61 x 3.89 mm
