zolotarev88/kicad_lib/3dmod/HRO_TYPE-C-31-M-12.step

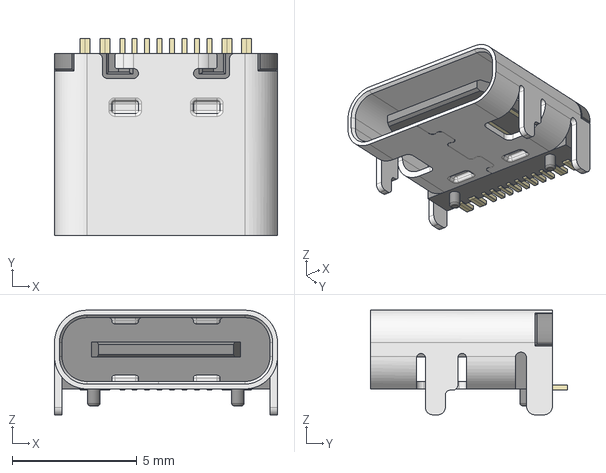
[picture p67: CAD file, 2020-07-18]
3dmod/HRO_TYPE-C-31-M-12.step
8.95 x 7.90 x 4.20 mm
