zolotarev88/kicad_lib/3dmod/WPM1481-6_TR.stp

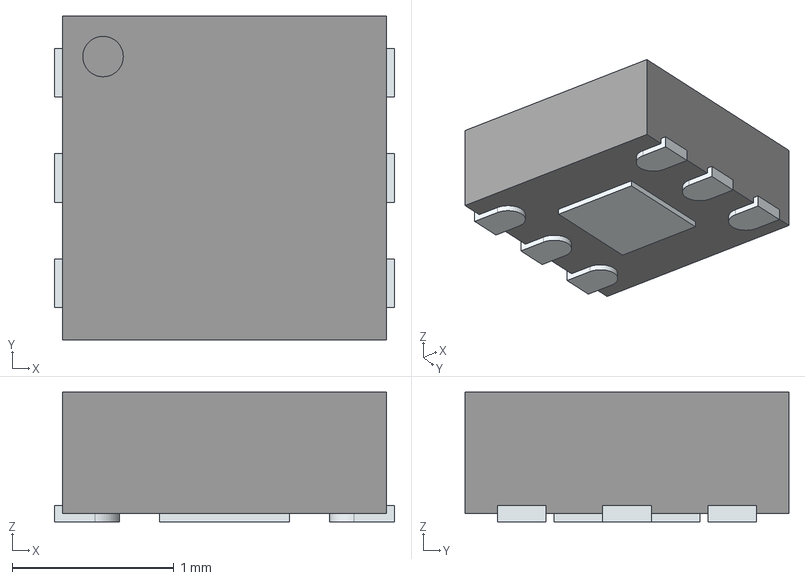
[picture p68: CAD file, 2020-06-26]
3dmod/WPM1481-6_TR.stp
2.10 x 2.00 x 0.8 mm
ThermalPin
PinsArrayLR
