zolotarev88/kicad_lib/3dmod/SY6280.stp

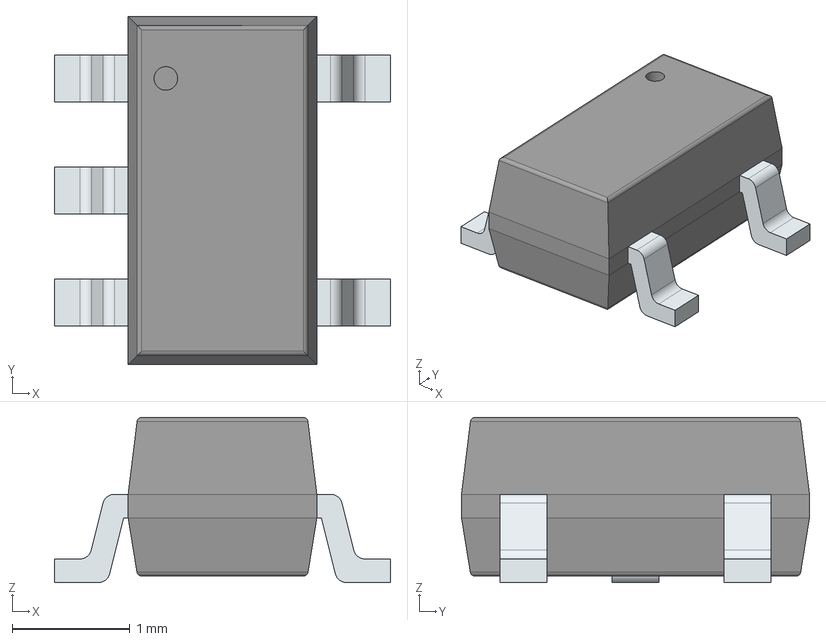
[picture p69: CAD file, 2020-06-26]
3dmod/SY6280.stp
2.85 x 2.95 x 1.40 mm
PinsArrayL
PinsArrayR
