zolotarev88/kicad_lib/3dmod/ALLWINNER_A64.stp

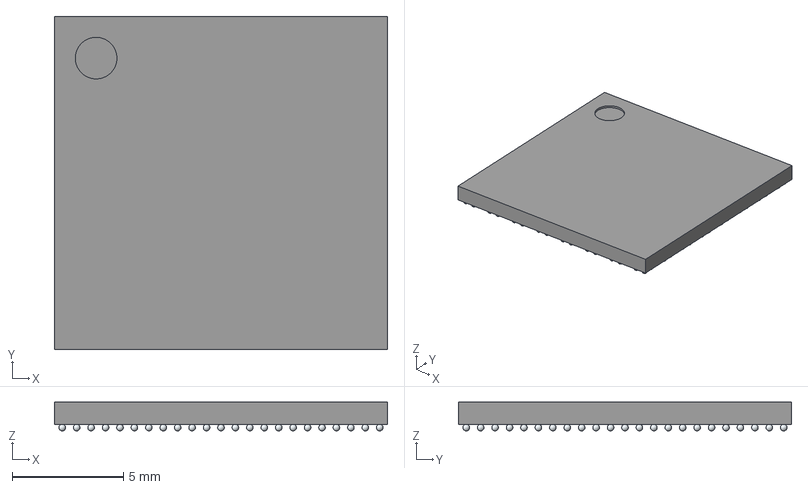
[picture p70: CAD file, 2020-06-23]
3dmod/ALLWINNER_A64.stp
15.0 x 15.0 x 1.30 mm
A1
A2
A4
A5
A7
A8
A11
A13
A14
A16
A17
A19
A20
A22
A23
B1
B2
B3
B4
B5
B6
B7
B8
B9
B10
B11
B12
B13
B14
B15
B16
B17
B18
B19
B20
B21
B22
B23
C2
C3
C4
C5
C6
C7
C8
C9
C10
C11
C12
C13
C14
C16
C17
C18
C19
C20
C22
D1
D2
D3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
