zolotarev88/kicad_lib/3dmod/MT29F8G08ADAFAWP-AIT_F_TR.stp

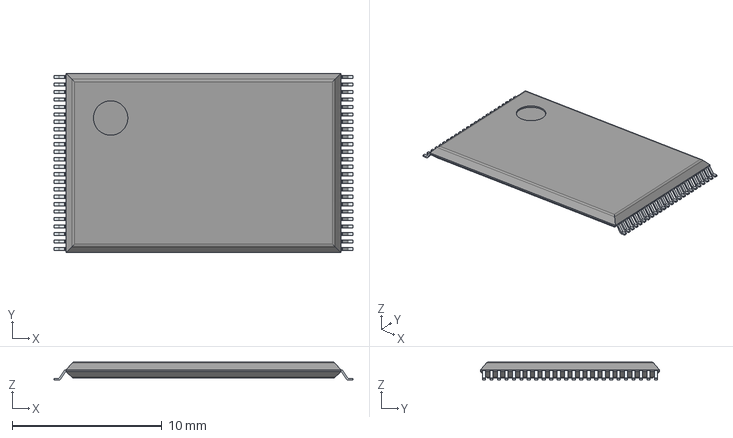
[picture p71: CAD file, 2020-06-23]
3dmod/MT29F8G08ADAFAWP-AIT_F_TR.stp
20.0 x 12.0 x 1.20 mm
PinsArrayLR
