zolotarev88/kicad_lib/3dmod/LM5109BMA_NOPB.stp

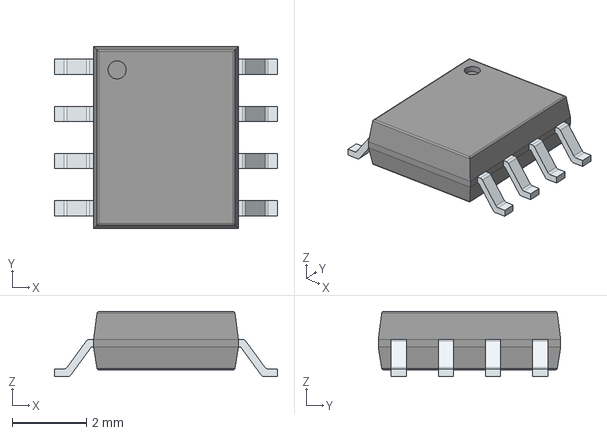
[picture p72: CAD file, 2020-06-23]
3dmod/LM5109BMA_NOPB.stp
6.00 x 4.91 x 1.75 mm
PinsArrayLR
