zolotarev88/kicad_lib/3dmod/AXP803.stp

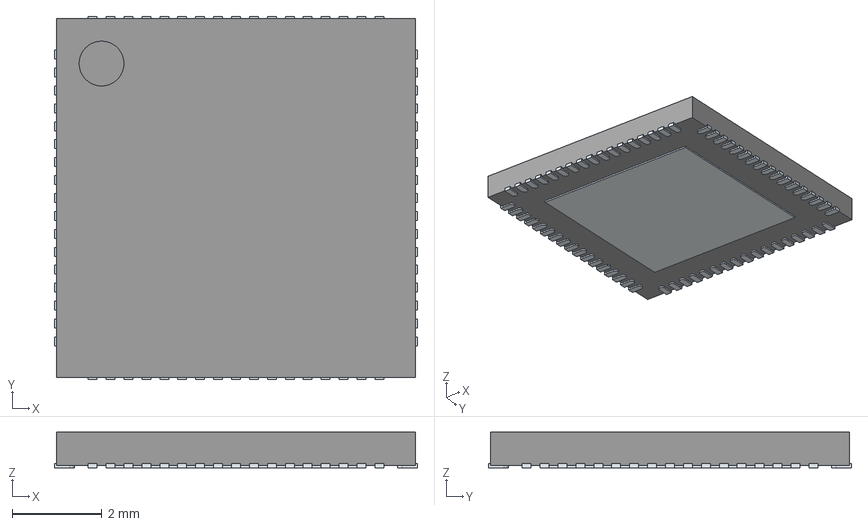
[picture p74: CAD file, 2020-06-23]
3dmod/AXP803.stp
8.10 x 8.10 x 0.8 mm
ThermalPin
PinsArrayLR
PinsArrayTB
