zolotarev88/kicad_lib/3dmod/15-24-4441.stp

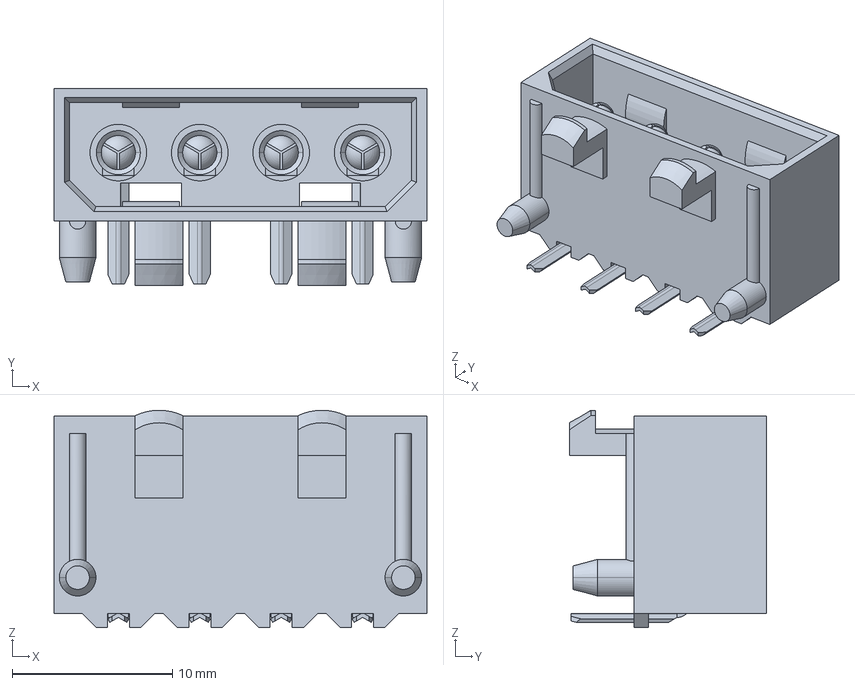
[picture p75: CAD file, 2020-06-23]
3dmod/15-24-4441.stp
23.3 x 12.3 x 13.6 mm
