zolotarev88/kicad_lib/3dmod/NLAS4599DFT2G.stp

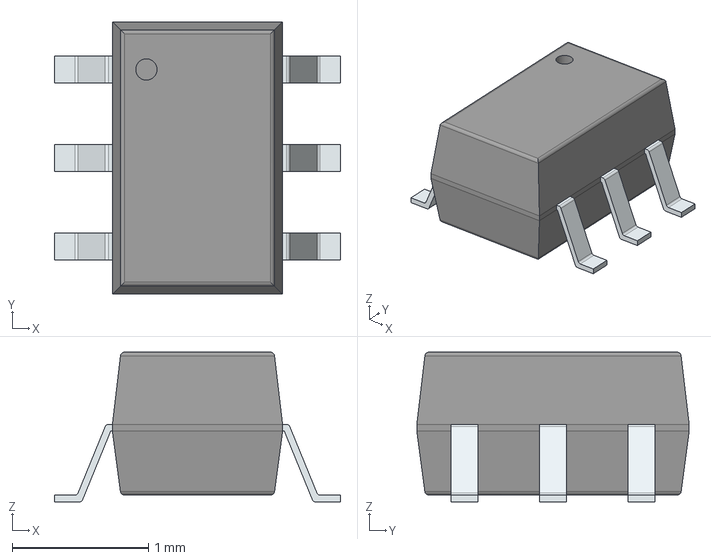
[picture p76: CAD file, 2020-06-23]
3dmod/NLAS4599DFT2G.stp
2.10 x 2.00 x 1.10 mm
PinsArrayLR
