zolotarev88/kicad_lib/3dmod/PN5180A0HN_C1E.stp

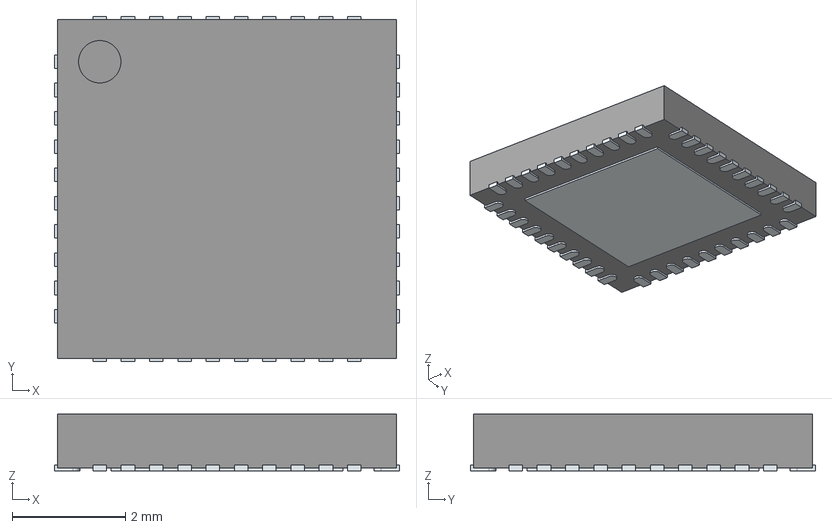
[picture p77: CAD file, 2020-06-23]
3dmod/PN5180A0HN_C1E.stp
6.10 x 6.10 x 1.00 mm
ThermalPin
PinsArrayLR
PinsArrayTB
