zolotarev88/kicad_lib/3dmod/MP2144GJ-Z.stp

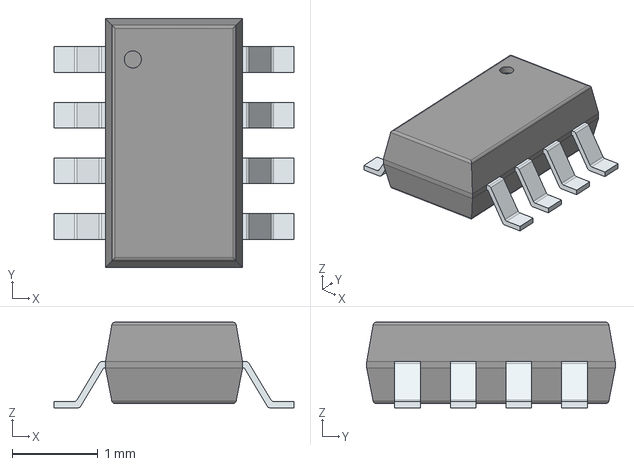
[picture p78: CAD file, 2020-06-23]
3dmod/MP2144GJ-Z.stp
2.80 x 2.90 x 1.00 mm
PinsArrayLR
