zolotarev88/kicad_lib/3dmod/RDA5807.stp

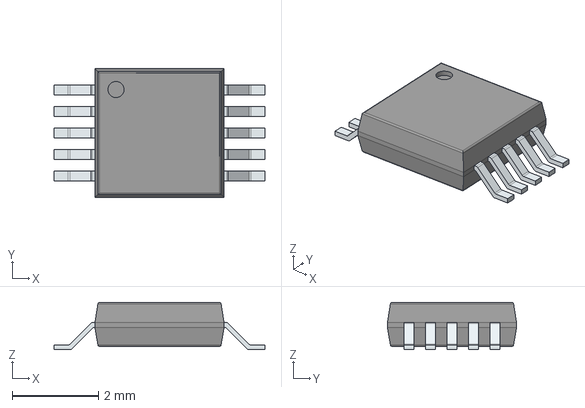
[picture p79: CAD file, 2020-06-23]
3dmod/RDA5807.stp
4.90 x 3.00 x 1.10 mm
PinsArrayLR
