zolotarev88/kicad_lib/3dmod/LTK5128.stp

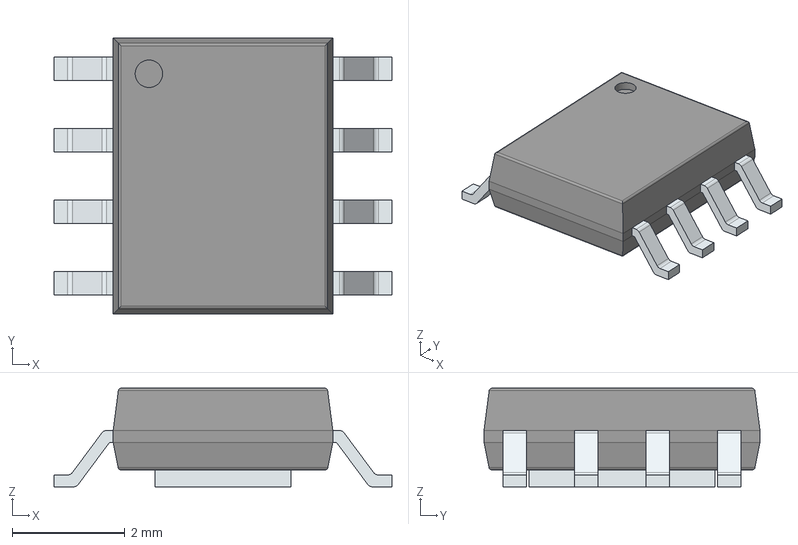
[picture p80: CAD file, 2020-06-23]
3dmod/LTK5128.stp
6.00 x 4.90 x 1.75 mm
PinsArrayLR
ThermalPad
