zolotarev88/kicad_lib/3dmod/PAM8403DR.stp

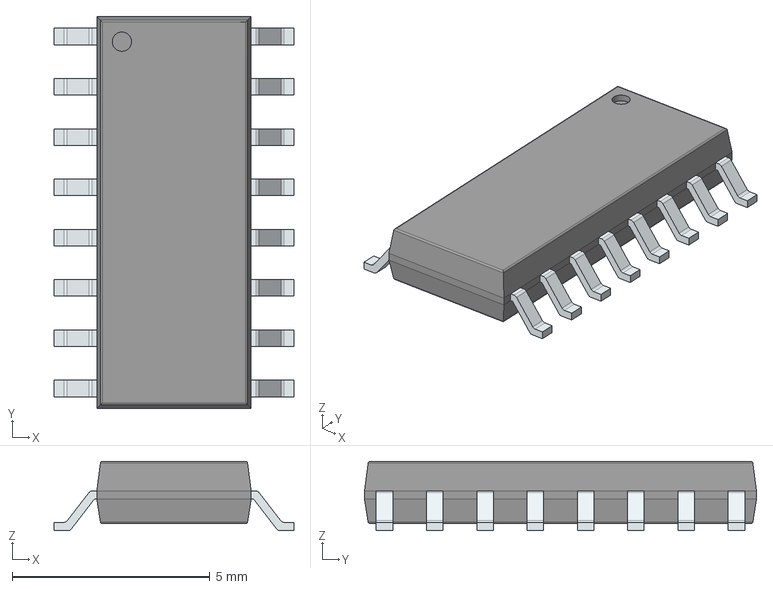
[picture p81: CAD file, 2020-06-23]
3dmod/PAM8403DR.stp
6.05 x 9.90 x 1.75 mm
PinsArrayLR
