zolotarev88/kicad_lib/(list of files, cad)

Other CAD files:
3dmod/pxc_2203902_02_ICC25-H-4L5-0-7035_3D.stp
3dmod/c-1-1747981-2-l-3d.stp
3dmod/MP3221GJ-P.stp
3dmod/MP3202DJ-LF-Z.stp
3dmod/PN532_C1.stp
3dmod/14388.stp
3dmod/1775862-2.stl
3dmod/1775862-2.stp
3dmod/2013978-1.stp
3dmod/2041021-4.stl
3dmod/2041021-4.stp
3dmod/314010001.stl
3dmod/314010001.stp
3dmod/47553-2001.stp
3dmod/68710614522.stp
3dmod/693072010801.stp
3dmod/AXP803.stl
3dmod/HR911105A.stp
3dmod/LM5109BMA_NOPB.stl
3dmod/LTK5128.stl
3dmod/MP2144GJ-Z.stl
3dmod/MP3202DJ-LF-Z.stl
3dmod/MP3221GJ-P.stl
3dmod/MT29F8G08ADAFAWP-AIT_F_TR.stl
3dmod/NLAS4599DFT2G.stl
3dmod/NT5CB128M16FP-DI.stl
3dmod/NT6AN256T32AV-J2.stl
3dmod/PAM8403DR.stl
3dmod/PN5180A0HN_C1E.stl
3dmod/PN532_C1.stl
3dmod/RDA5807.stl
3dmod/SY6280.stl
3dmod/WPM1481-6_TR.stl
3dmod/bat14350.step
