zolotarev88/kicad_lib/(commit log)

2020-06-23 add some components
    [LTK5128.stl, LTK5128.stp, MP2144GJ-Z.stl, MP2144GJ-Z.stp, MP3202DJ-LF-Z.stl, MP3202DJ-LF-Z.stp, MP3221GJ-P.stl, MP3221GJ-P.stp]
2020-06-23 add some components again
    [15-24-4441.stp, 314010001.stl, 314010001.stp, ALLWINNER_A64.stp, AXP803.stl, AXP803.stp, LM5109BMA_NOPB.stl, LM5109BMA_NOPB.stp]
2020-07-18 add new component
    [2-2013022-1.stp, HRO_TYPE-C-31-M-12.step, USB Type C Port (SMD Type).STEP, c-1-1747981-2-l-3d NEW.STEP, c-1-1747981-2-l-3d.stp, c-8-1747981-1-l-3d.stp]
2020-07-22 new comp
    [14388.stp, 2041021-4.stp, User Library-JST_B2B-PH-SM4-TB-white.step, User Library-LED_RGB _4SMD.step, User Library-PTS645SL43SMTR92-LFS.STEP, User Library-ltst-s310f2kt.step]
2020-08-24 add new comp
    [ADM2682EBRIZ.stp, AM1D-0505SZ.stp, L-7104FO-2GD_.stp, NSS1C201LT1G.stp, NT6AN256T32AV-J2.stl, NT6AN256T32AV-J2.stp, PJ-327F-5A.STEP, PS2801C-1-F3-A.stp]
2020-09-14 новые компоненты и модели
    [3-1734592-5.stp, 3-1734839-0--3DModel-STEP-56544.STEP, 6027.step, 68710614522.stp, SM04B-SRSS-TB(LF)(SN)--3DModel-STEP-56544.STEP, SWPA3015S2R2NT.stp, SWPA4012S2R2NT--3DModel-STEP-56544.STEP, User Library-FFC 6x05.step]
2020-10-01 sopine connector change
2021-03-23 new com
    [WM8904CGEFL_V.stp, WM8960CGEFL_V.stp, WM8962BECSN_R.stp]
2021-04-29 new comp for sensor
    [BS-7.STEP, CR2032_MFR_FH2.stp, QFN24_3X3X1_IVS.step, SI3402-B-GMR.stp, TD_H_541S485H.stp]
2025-03-10 очередной для библиотеки
    [DG142V-5.08-08P-1Y-1000A(H).stp, DG28C-B-08P-13-00A(H).stp, FD6288Q.step, G5Q-14-EU DC5--3DModel-STEP-1.STEP, LD05-23BxxR2.stp, bat14350.step]
